ogoldeliy/fachwerk-project-173/Ведомости/04 ижд Ведомость.docx

# Список деталей

№стр. | Пор. № | Идент. № | Наименование | Кол. | Ш [мм] | В [мм] | Д [мм]
1 | 1 | Ель | Стойка | 3 | 100 | 200 | 590
2 | 2 | Ель | Поперечный подкос стены | 7 | 60 | 280 | 1436,863
3 | 1013 | Ель | Штихбалка | 1 | 100 | 200 | 4000
4 | 2000 | Ель | Стропила | 5 | 60 | 200 | 7700
5 | 2001 | Ель | Стропила | 5 | 60 | 200 | 2554,227
6 | 2002 | Ель | Стропила | 19 | 60 | 200 | 6707,021
7 | 2003 | Ель | Стропила | 10 | 60 | 280 | 5385,251
8 | 2004 | Ель | Стропила | 5 | 60 | 200 | 1545,027
9 | 4000 | Ель | Мауэрлат | 1 | 200 | 200 | 4000
10 | 4001 | Ель | Мауэрлат | 1 | 200 | 200 | 4000
11 | 4002 | Ель | Мауэрлат | 1 | 160 | 200 | 1664
12 | 4003 | Ель | Мауэрлат | 1 | 160 | 200 | 7793,067
13 | 4004 | Ель | Мауэрлат | 1 | 200 | 200 | 6910
14 | 4005 | Ель | Мауэрлат | 1 | 200 | 200 | 6910
15 | 4006 | Ель | Мауэрлат | 1 | 200 | 200 | 9060
16 | 4007 | Ель | Мауэрлат | 1 | 200 | 200 | 3720
17 | 4008 | Ель | Мауэрлат | 1 | 200 | 200 | 3720
18 | 4009 | Ель | Мауэрлат | 1 | 200 | 200 | 6895
19 | 4010 | Ель | Мауэрлат | 1 | 200 | 200 | 5685
20 | 4011 | Ель | Мауэрлат | 1 | 200 | 200 | 3495
21 | 4012 | Ель | Мауэрлат | 1 | 200 | 200 | 5685
22 | 4013 | Ель | Стропила | 1 | 200 | 200 | 7700
23 | 4014 | Ель | Стропила | 1 | 160 | 160 | 1698,766
24 | 4015 | Ель | Стропила | 1 | 200 | 200 | 6707,021
25 | 4016 | Ель | Стропила | 1 | 160 | 280 | 5385,251
26 | 4017 | Ель | Стропила | 1 | 160 | 280 | 5385,251
27 | 4018 | Ель | Стропила | 1 | 160 | 280 | 5385,251
28 | 4019 | Ель | Стропила | 1 | 160 | 280 | 5385,251
29 | 4020 | Ель | Стропила | 1 | 200 | 200 | 6707,021
30 | 4021 | Ель | Стропила | 1 | 200 | 200 | 6707,021
31 | 4022 | Ель | Затяжка | 1 | 60 | 200 | 6240
32 | 4023 | Ель | Затяжка | 1 | 60 | 200 | 7430
33 | 4024 | Ель | Затяжка | 1 | 60 | 200 | 709,999
34 | 4025 | Ель | Затяжка | 1 | 60 | 200 | 6240
35 | 4026 | Ель | Затяжка | 1 | 60 | 200 | 11710
36 | 4027 | Ель | Вспомогательная балка | 1 | 100 | 200 | 1970
37 | 4028 | Ель | Вспомогательная балка | 1 | 100 | 280 | 8239,943
38 | 4029 | Ель | Балка | 1 | 100 | 280 | 8319,943
39 | 4030 | Ель | Балка | 1 | 100 | 280 | 9580
40 | 4031 | Ель | Вспомогательная балка | 1 | 100 | 200 | 4060
41 | 4032 | Ель | Вспомогательная балка | 1 | 100 | 200 | 4060
42 | 4033 | Ель | Балка | 1 | 100 | 280 | 9580
43 | 4034 | Ель | Вспомогательная балка | 1 | 100 | 200 | 3180
44 | 4035 | Ель | Балка | 1 | 100 | 280 | 8319,943
45 | 4036 | Ель | Вспомогательная балка | 1 | 100 | 200 | 1970
46 | 4037 | Ель | Нижн. обвязка | 1 | 200 | 200 | 1945
47 | 4038 | Ель | Нижн. обвязка | 1 | 160 | 200 | 6205
48 | 4039 | Ель | Нижн. обвязка | 1 | 160 | 200 | 6205
49 | 4040 | Ель | Нижн. обвязка | 1 | 200 | 280 | 2045
50 | 4041 | Ель | Нижн. обвязка | 1 | 160 | 200 | 11675,001
51 | 4042 | Ель | Нижн. обвязка | 1 | 200 | 280 | 11675,001
52 | 4043 | Ель | Нижн. обвязка | 1 | 200 | 280 | 4540
53 | 4044 | Ель | Нижн. обвязка | 1 | 200 | 280 | 8520
54 | 4045 | Ель | Нижн. обвязка | 1 | 200 | 280 | 7395
55 | 4046 | Ель | Нижн. обвязка | 1 | 200 | 200 | 10365
56 | 4047 | Ель | Нижн. обвязка | 1 | 160 | 200 | 4540
57 | 4048 | Ель | Нижн. обвязка | 1 | 160 | 200 | 1945
58 | 4049 | Ель | Нижн. обвязка | 1 | 160 | 200 | 11710
59 | 4050 | Ель | Нижн. обвязка | 1 | 160 | 199,999 | 6205
60 | 4051 | Ель | Нижн. обвязка | 1 | 160 | 199,999 | 6205
61 | 4052 | Ель | Нижн. обвязка | 1 | 160 | 200 | 1945
62 | 4053 | Ель | Нижн. обвязка | 1 | 200 | 280 | 11735
63 | 4054 | Ель | Нижн. обвязка | 1 | 200 | 200 | 1945
64 | 4055 | Ель | Верхн. обвязка | 1 | 200 | 200 | 1050
65 | 4056 | Ель | Верхн. обвязка | 1 | 200 | 280 | 1200
66 | 4057 | Ель | Верхн. обвязка | 1 | 200 | 280 | 1200,057
67 | 4058 | Ель | Верхн. обвязка | 1 | 200 | 200 | 1040
68 | 4059 | Ель | Верхн. обвязка | 1 | 200 | 280 | 9480
69 | 4060 | Ель | Верхн. обвязка | 1 | 200 | 200 | 8160
70 | 4061 | Ель | Верхн. обвязка | 1 | 200 | 280 | 8120
71 | 4062 | Ель | Нижн. обвязка | 1 | 200 | 200 | 4680
72 | 4063 | Ель | Столб | 1 | 200 | 200 | 2379,519
73 | 4064 | Ель | Столб | 1 | 200 | 200 | 2170
74 | 4065 | Ель | Столб | 1 | 200 | 200 | 2379,519
75 | 4066 | Ель | Столб | 1 | 200 | 200 | 3252,115
76 | 4067 | Ель | Столб | 1 | 200 | 200 | 3040
77 | 4068 | Ель | Столб | 1 | 200 | 200 | 3040
78 | 4069 | Ель | Столб | 1 | 160 | 200 | 1690
79 | 4070 | Ель | Столб | 1 | 60 | 200 | 780
80 | 4071 | Ель | Столб | 1 | 200 | 200 | 3040
81 | 4072 | Ель | Столб | 1 | 160 | 200 | 1690
82 | 4073 | Ель | Столб | 1 | 160 | 200 | 1690
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
160 x 280 | 4 | 21,540 | 19,316 | 0,964
200 x 200 | 57 | 213,132 | 175,068 | 8,523
200 x 280 | 10 | 65,910 | 64,393 | 3,691

www.dietrichs.com 4/4 Создано в Dietrich´s

www.dietrichs.com 1/4 Создано в Dietrich´s

Проект: _Оси 29.05.2019 Обьект: Координатна сетка
