ogoldeliy/fachwerk-project-173/Ведомости/04 ижд Доска.docx

# Список деталей

№стр. | Пор. № | Идент. № | Наименование | Кол. | Ш [мм] | В [мм] | Д [мм]
1 | 1000 | Сосна | Затяжка | 7 | 45 | 190 | 838,074
2 | 1001 | Сосна | Штихбалка | 1 | 45 | 190 | 1920
3 | 1002 | Сосна | Штихбалка | 6 | 45 | 190 | 1569,998
4 | 1003 | Сосна | Штихбалка | 3 | 45 | 190 | 1570,003
5 | 1004 | Сосна | Штихбалка | 21 | 45 | 145 | 1990
6 | 1005 | Сосна | Штихбалка | 7 | 45 | 145 | 1990,001
7 | 1006 | Сосна | Штихбалка | 3 | 45 | 190 | 1900,001
8 | 1007 | Сосна | Штихбалка | 14 | 45 | 145 | 1570,001
9 | 1008 | Сосна | Штихбалка | 7 | 45 | 145 | 1570
10 | 1009 | Сосна | Штихбалка | 6 | 45 | 190 | 1920
11 | 1010 | Сосна | Штихбалка | 21 | 45 | 145 | 1570,001
12 | 1011 | Сосна | Штихбалка | 3 | 45 | 190 | 1900,001
13 | 1012 | Сосна | Штихбалка | 1 | 45 | 190 | 1919,999
14 | 1014 | Сосна | Штихбалка | 9 | 45 | 190 | 1570,001
15 | 1015 | Сосна | Штихбалка | 6 | 45 | 190 | 1990
16 | 1016 | Сосна | Штихбалка | 1 | 45 | 190 | 4000
17 | 1017 | Сосна | Штихбалка | 2 | 45 | 190 | 4080
18 | 1018 | Сосна | Штихбалка | 8 | 45 | 190 | 4080
19 | 1019 | Сосна | Штихбалка | 8 | 45 | 190 | 4210
20 | 1020 | Сосна | Штихбалка | 2 | 45 | 190 | 4080
21 | 1021 | Сосна | Штихбалка | 1 | 45 | 190 | 4000
22 | 1022 | Сосна | Штихбалка | 8 | 45 | 190 | 2840

# Ведомость сечений

Каталожный№ | Кол. [Шт.] | Пог.м [м] | Повер. [м²] | Объём [м³]
Доска | 145 | 307,847 | 135,933 | 2,385
Итого | 145 | 307,847 | 135,933 | 2,385
45 x 145 | 70 | 121,660 | 47,145 | 0,794
45 x 190 | 69 | 174,247 | 83,074 | 1,489
45 x 190 | 6 | 11,940 | 5,714 | 0,102

www.dietrichs.com 2/2 Создано в Dietrich´s

www.dietrichs.com 1/1 Создано в Dietrich´s

Проект: _Оси 29.05.2019 Обьект: Координатна сетка
