ogoldeliy/fachwerk-project-173/(list of files, cad)

Other CAD files:
02 ижд АР.dwg
