ogoldeliy/fachwerk-project-173/02 ижд АР.pdf

Общий вид. Аксонометрия.

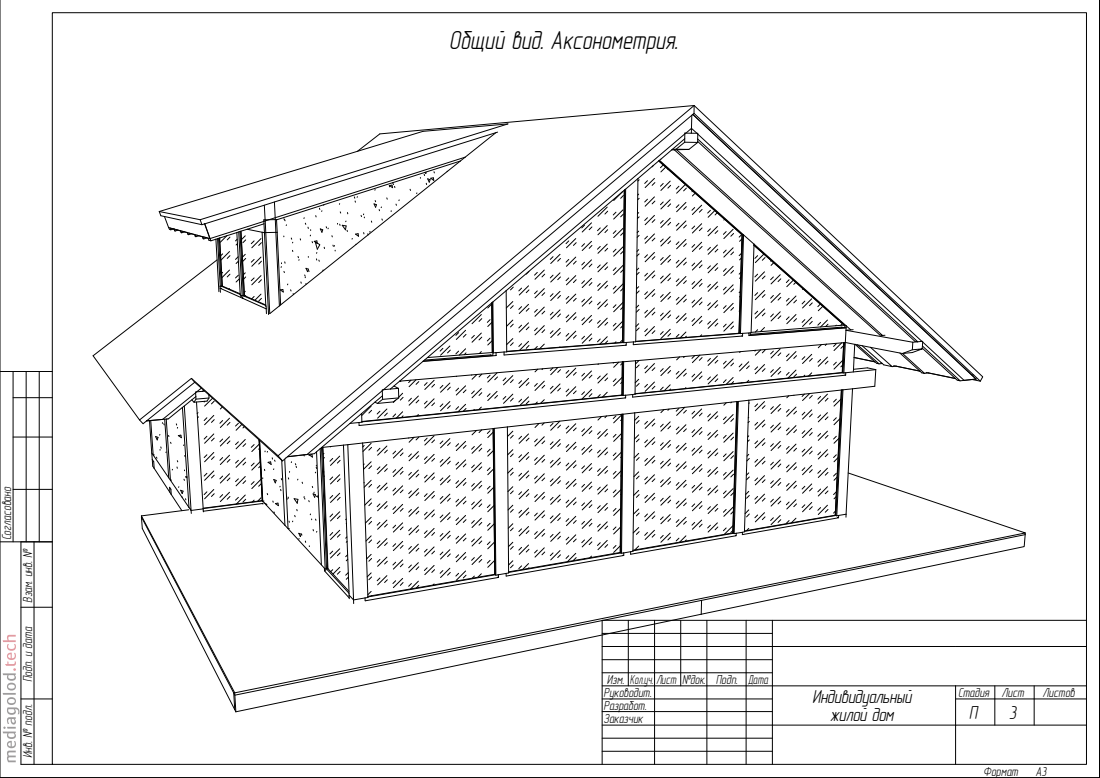
[picture p1: page 1]
Стадия; Лист; Листов; Индивидуальный; жилой дом; Соглас; ван; Формат A3

Инв. № подл. Подп. и дата Взам. инв. №

Изм. Кол.уч. Лист №док. Руководит. | Подп. | Дата
Разработ.
Заказчик

# Общий вид. Аксонометрия. Инв. № подл. Подп. и дата Взам. инв. №

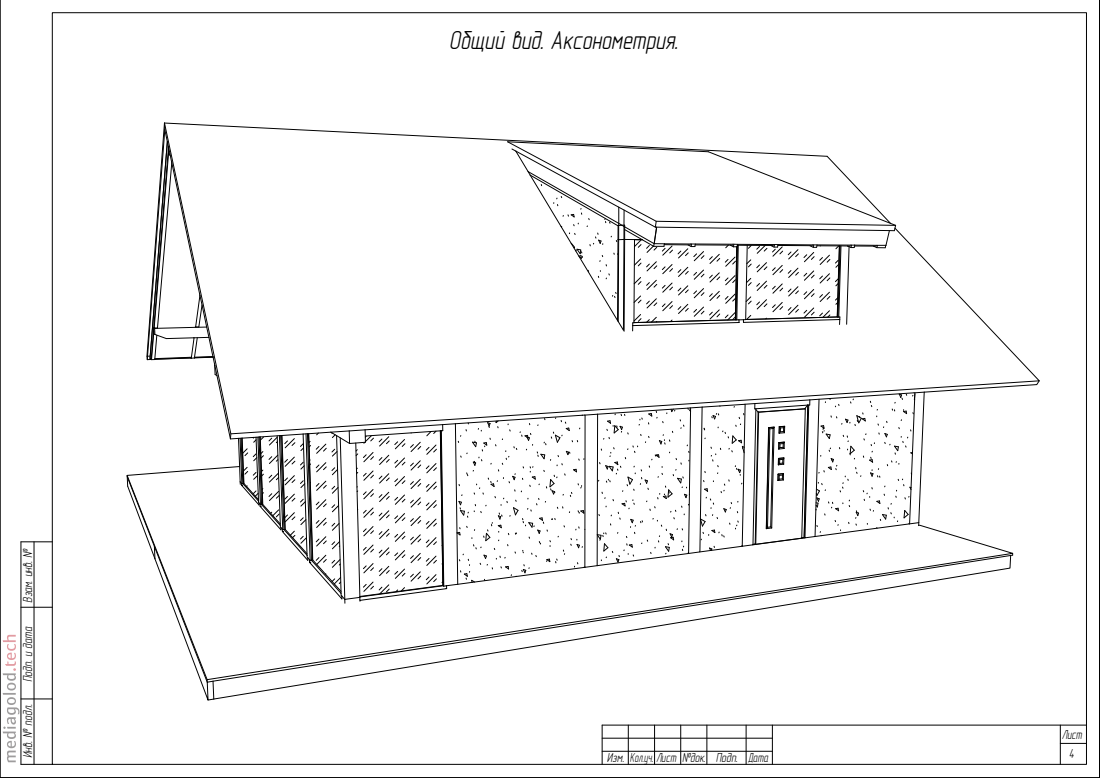
[picture p2: page 2]
Изм. Кол.уч. Лист №док.; Подп.; Дата; Лист

# Общий вид. Аксонометрия. Инв. № подл. Подп. и дата Взам. инв. №

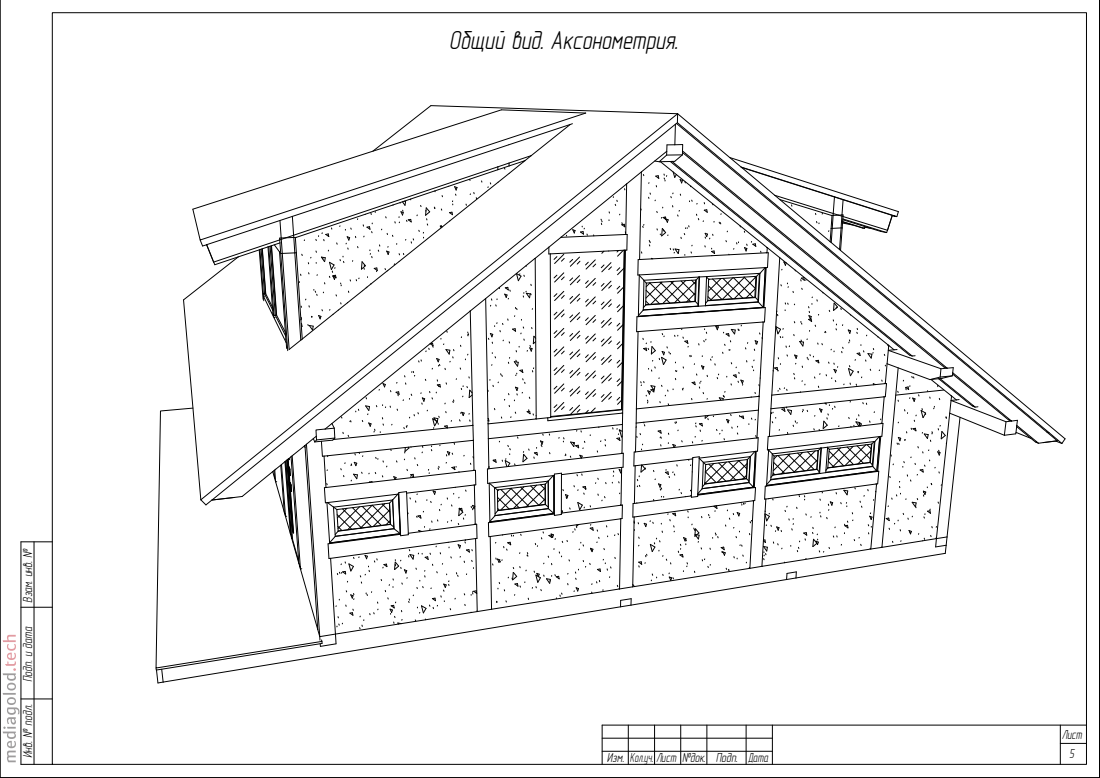
[picture p3: page 3]

# Общий вид. Аксонометрия. Инв. № подл. Подп. и дата Взам. инв. №

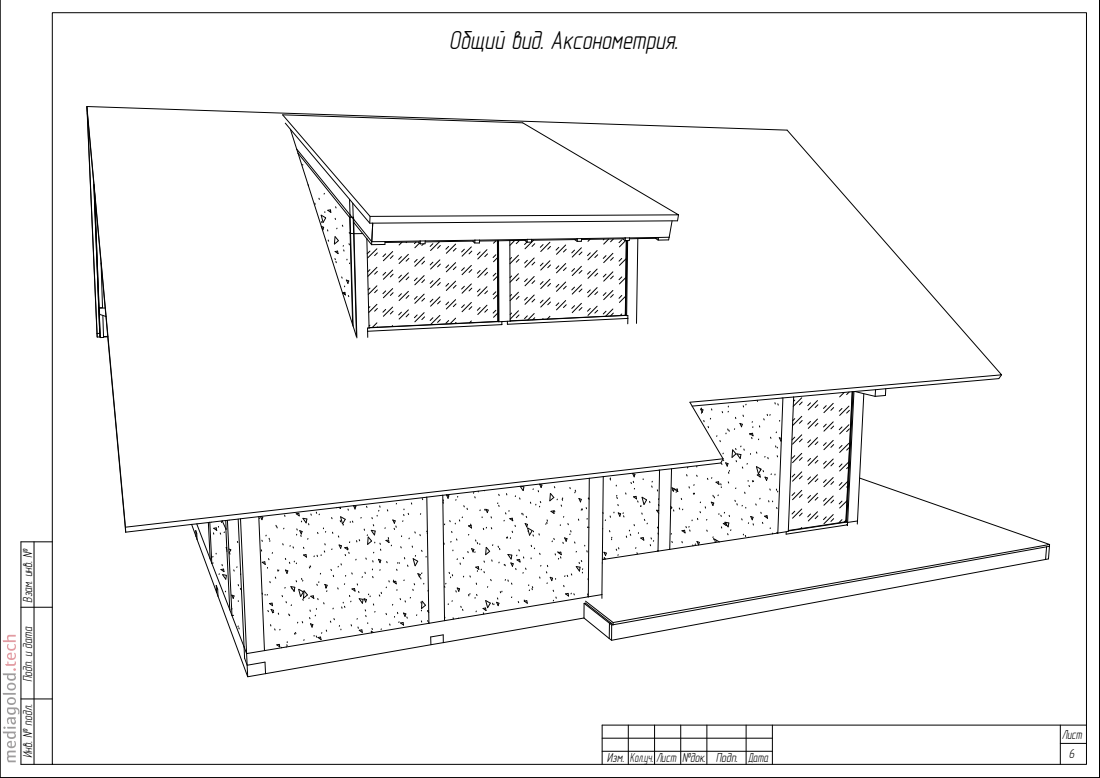
[picture p4: page 4]

# План

# первого

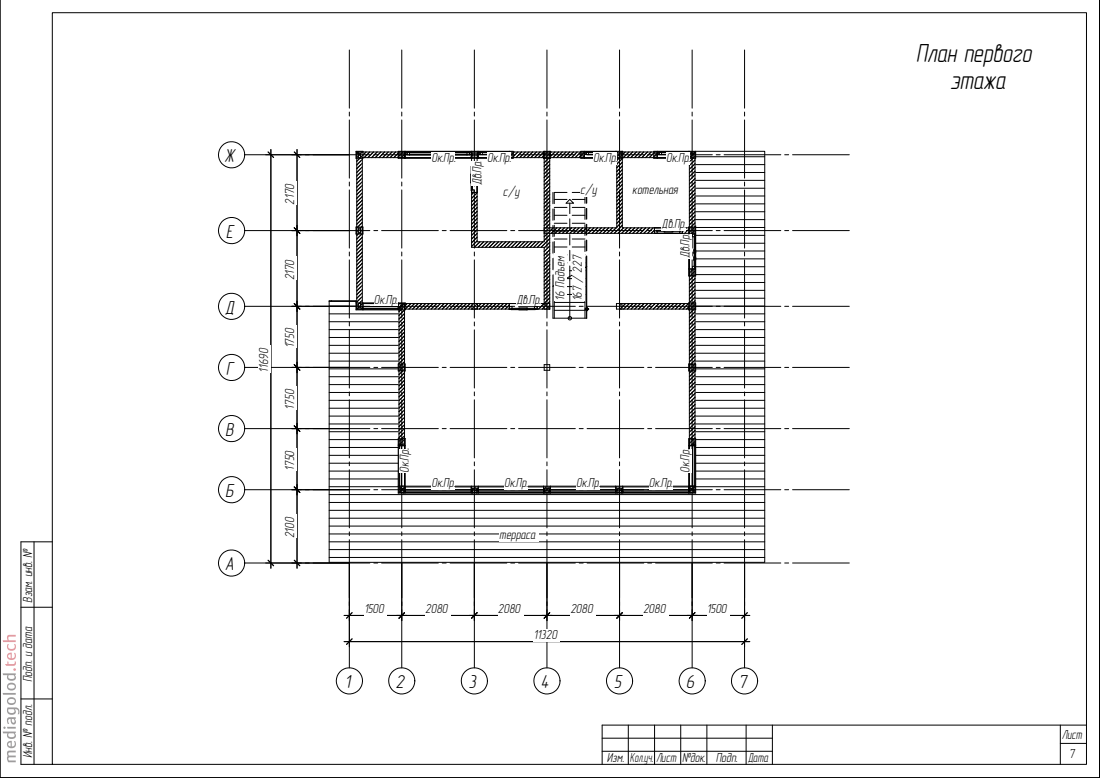
[picture p5: page 5]
ажа; План; первого эт; ерраса; тель; ная; 167 / ²²⁷ Подъем терраса; 167 / ²²⁷ Подъем; №док.; Подп.; Дата; Лист7

Инв. № подл. Подп. и дата Взам. инв. №

Изм. Кол.уч. Лист

# План

вт

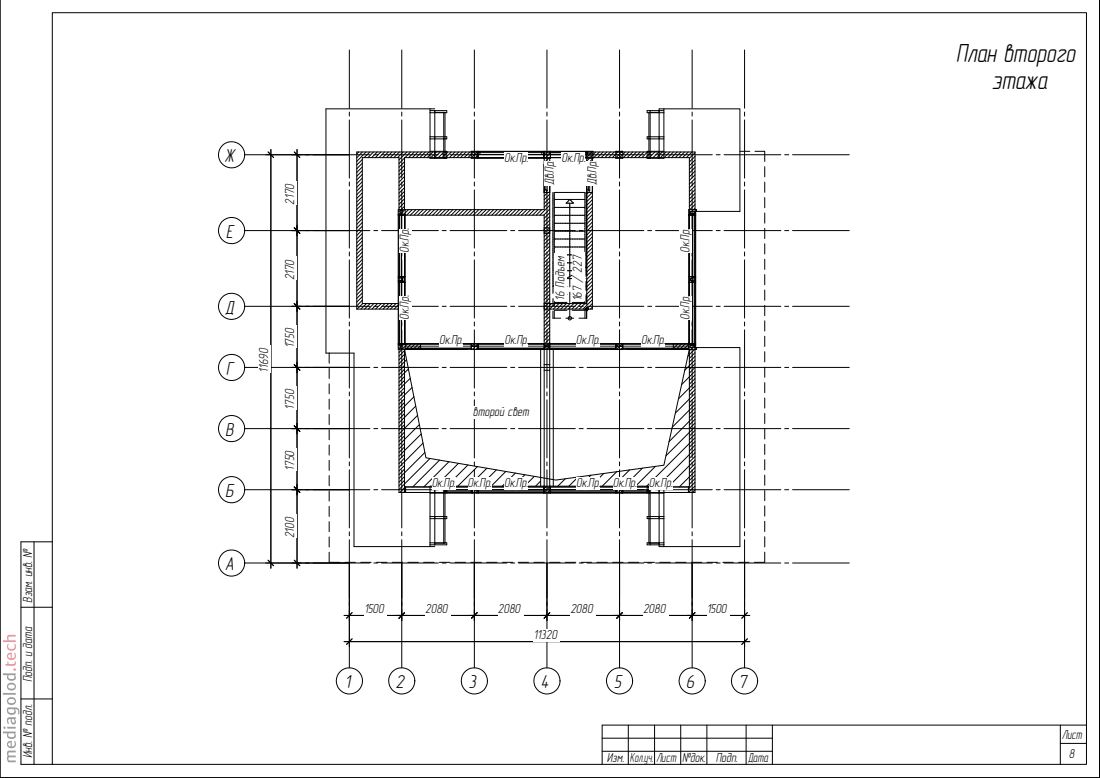
[picture p6: page 6]
орого; ажа; План; орой; свет; 167 / ²²⁷ Подъем; №док.; Подп.; Дата; Лист8

Инв. № подл. Подп. и дата Взам. инв. №

Изм. Кол.уч. Лист

# План

# кровли

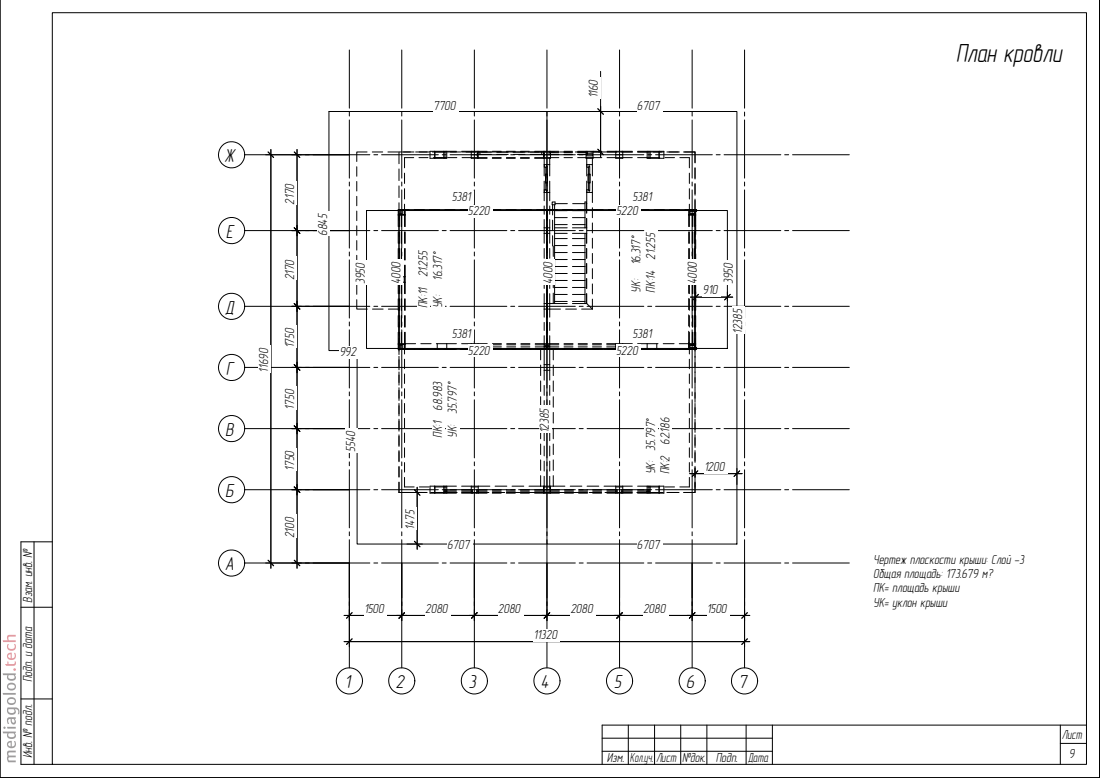
[picture p7: page 7]
лоскости крыши:; Слой -; адь: 173.679; Чертеж; Общая; площ; №док.; Подп.; Дата; Лист9

Инв. № подл. Подп. и дата Взам. инв. №

Чертеж
Общая
ПК= площадь крыши
УК= уклон крыши

площ

Изм. Кол.уч. Лист

# Фасад в осях Е-А

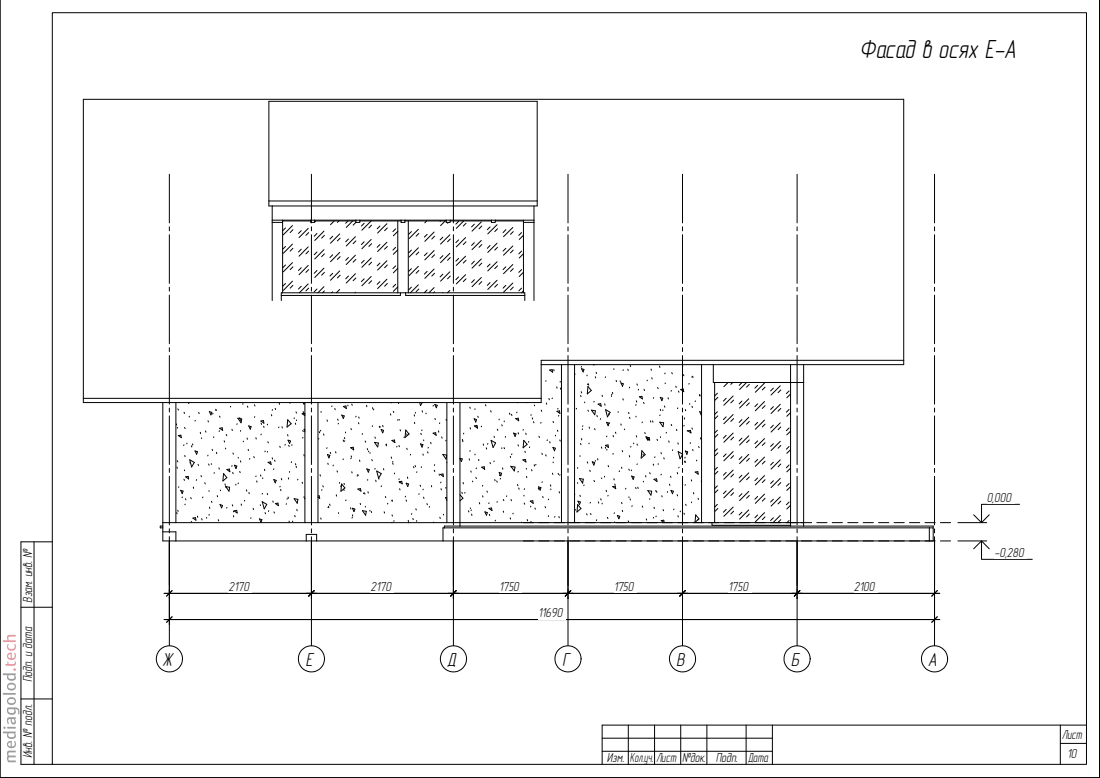
[picture p8: page 8]

Инв. № подл. Подп. и дата Взам. инв. №

# Фасад в осях 1-4

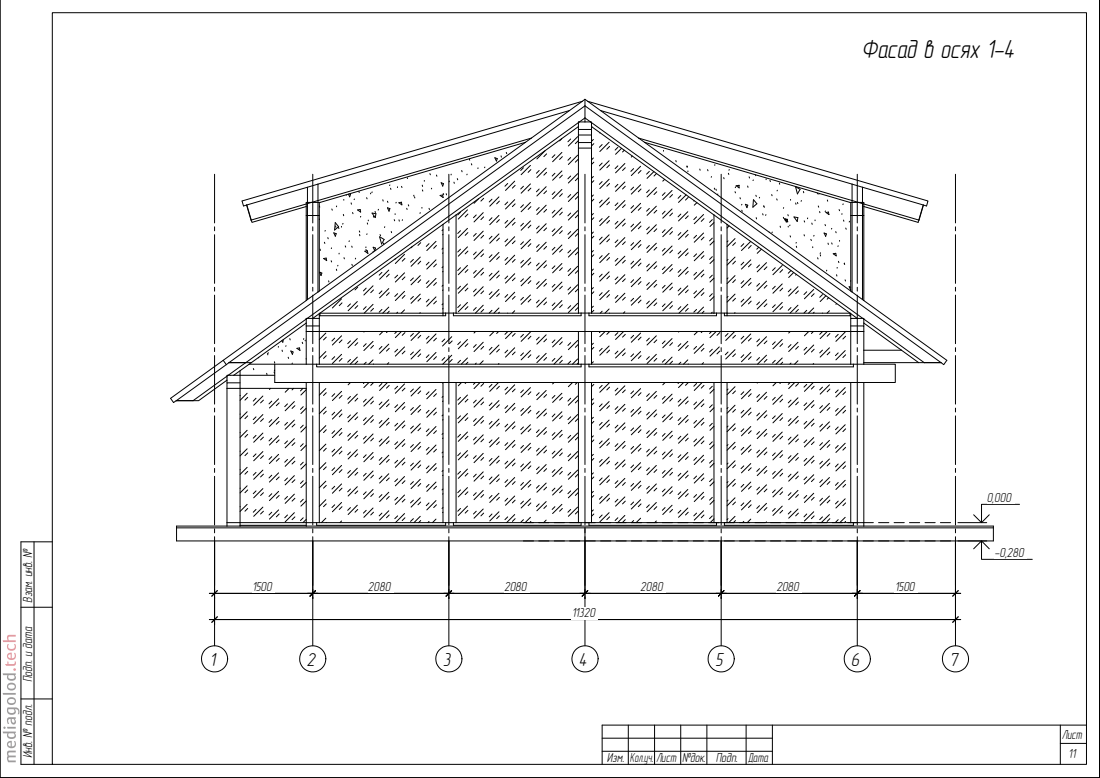
[picture p9: page 9]

Инв. № подл. Подп. и дата Взам. инв. №

# Фасад в осях 4-1

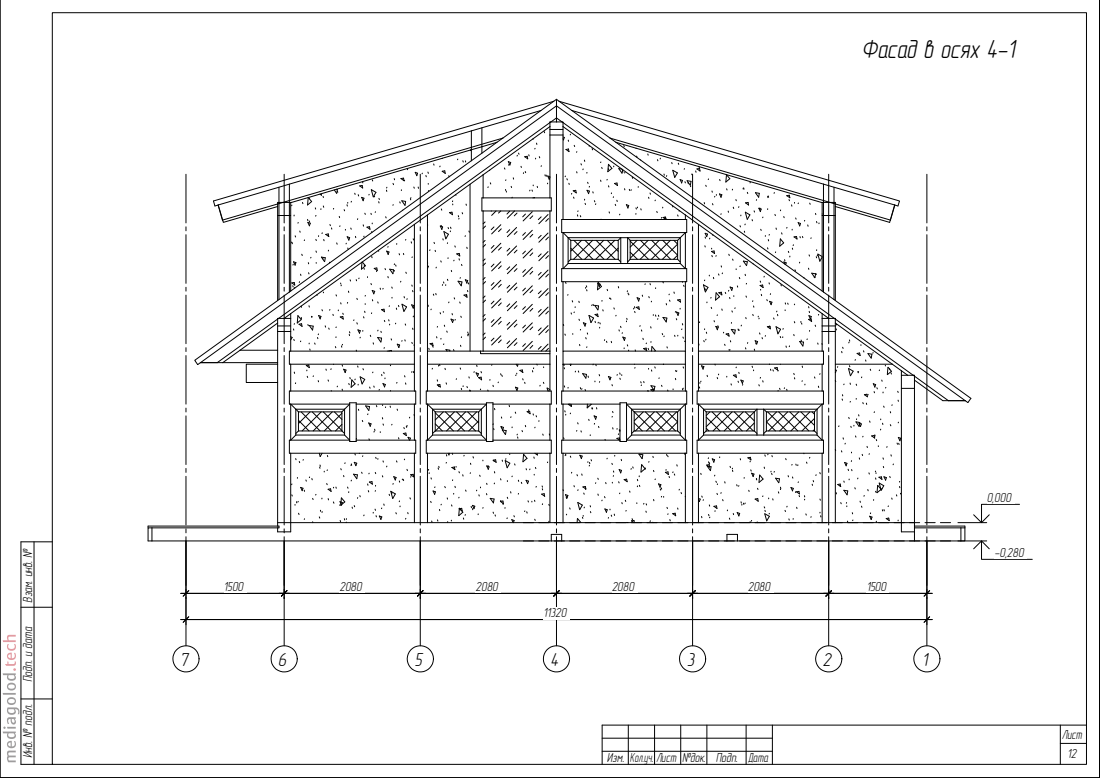
[picture p10: page 10]

Инв. № подл. Подп. и дата Взам. инв. №

# Фасад в осях А-Е

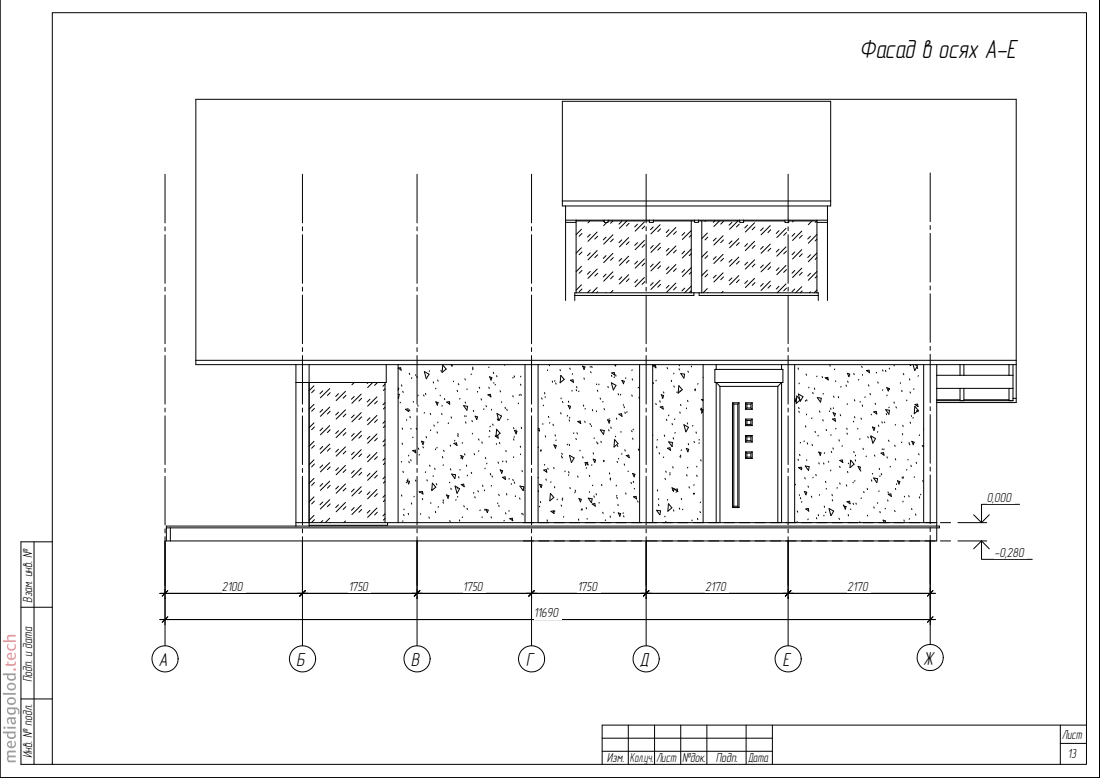
[picture p11: page 11]

Инв. № подл. Подп. и дата Взам. инв. №

# Разрез 1-1

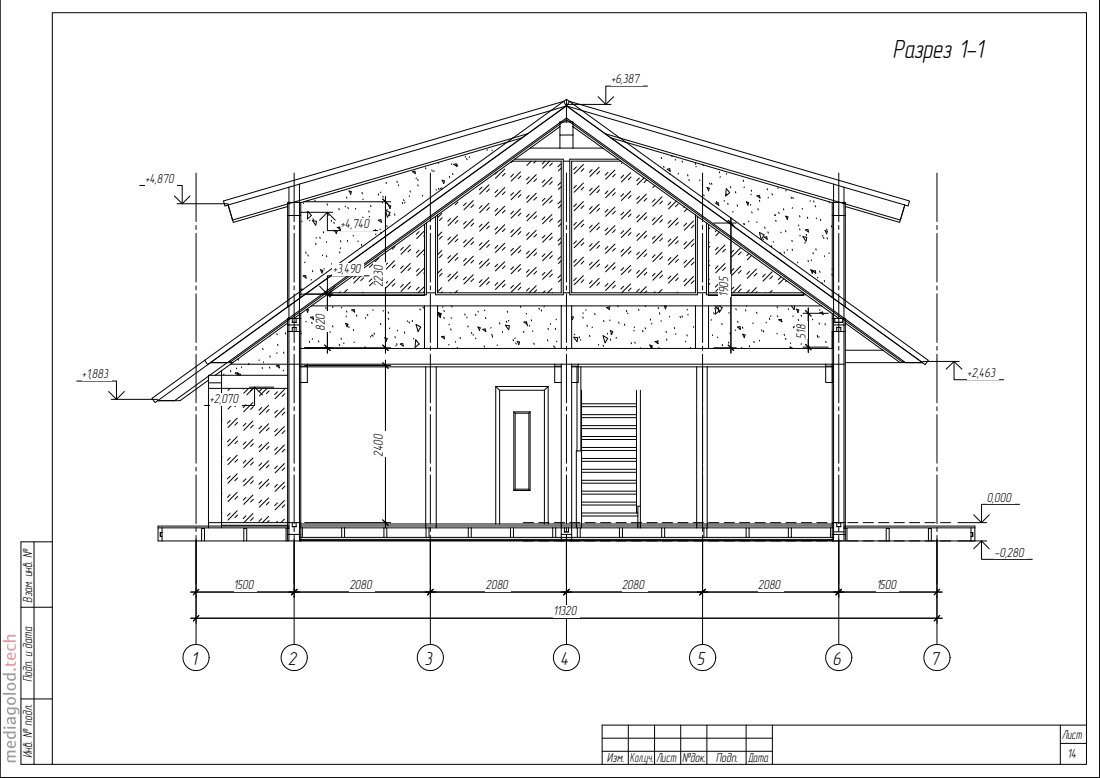
[picture p12: page 12]

Инв. № подл. Подп. и дата Взам. инв. №
