ogoldeliy/fachwerk-project-173/02 ижд Планы.pdf

# План

# первого

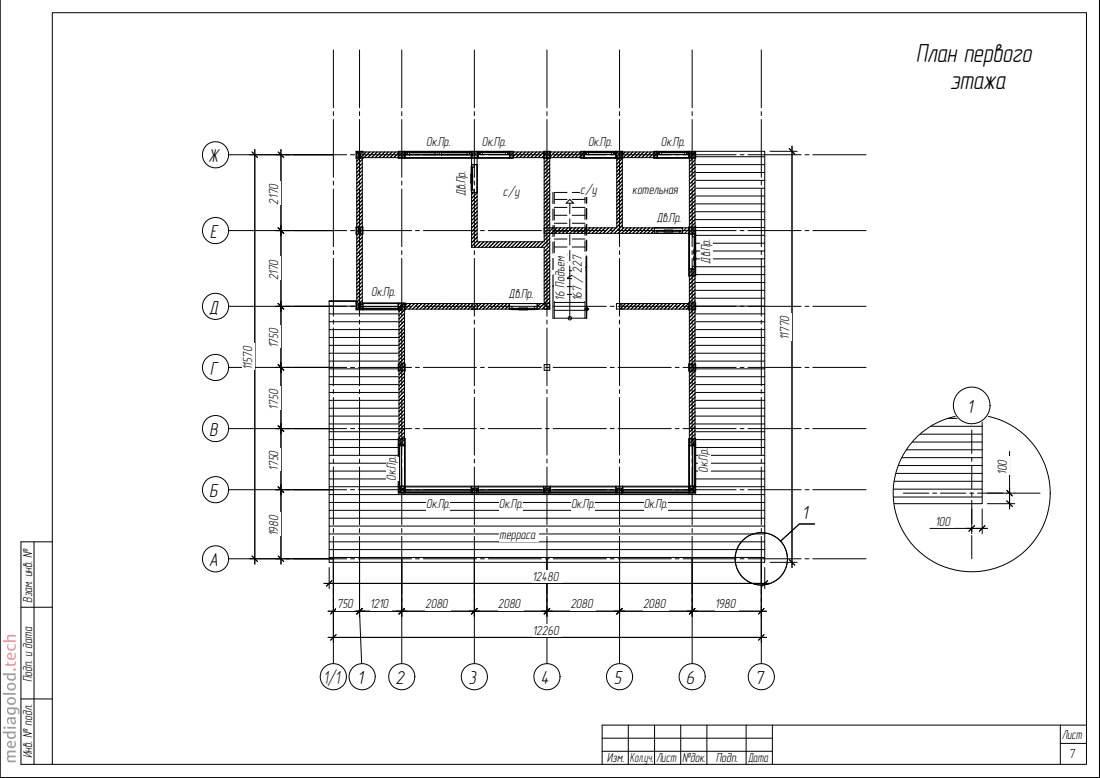
[picture p13: page 1]
ажа; План; первого эт; ерраса с/у; тель; ная; 167 / ²²⁷ Подъем терраса с/у; котельная; 167 / ²²⁷ Подъем; №док.; Подп.; Дата; Лист7

Инв. № подл. Подп. и дата Взам. инв. №

Изм. Кол.уч. Лист
