ogoldeliy/fachwerk-project-173/03 ижд КД.pdf

# План раскладки балок нижней обвязки

Ж

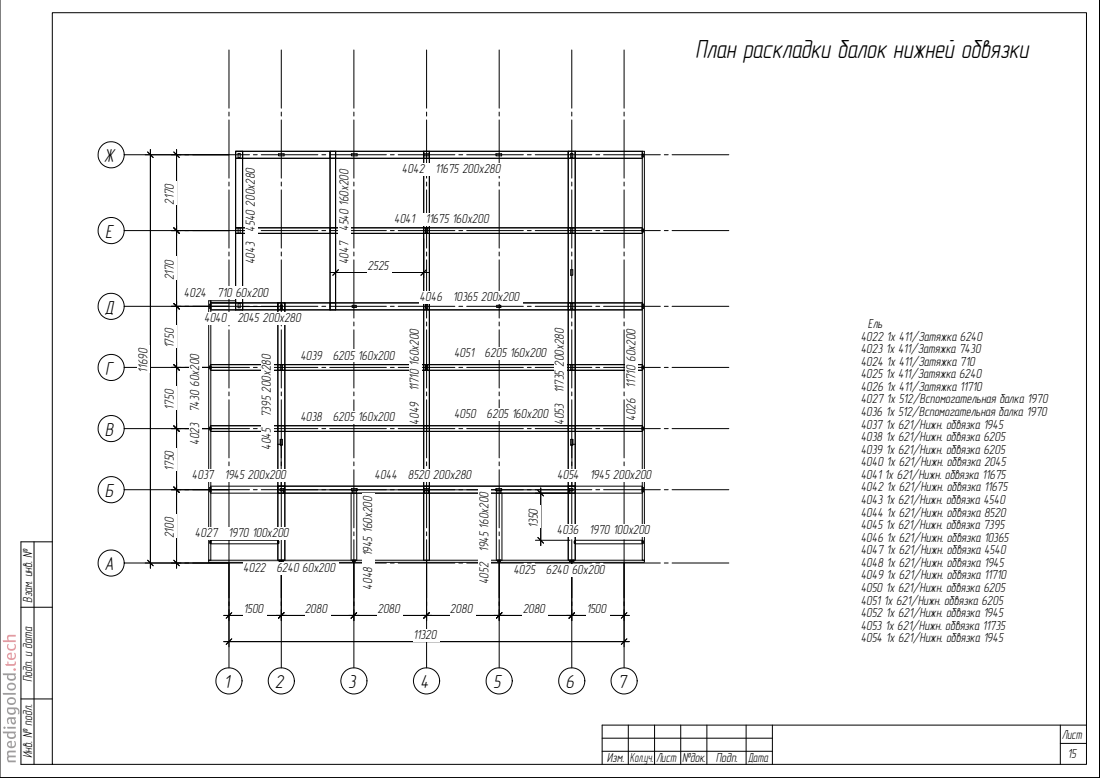
[picture p14: page 1]
Ель 4022 1x 411/Затяжка 6240 4023 1x 411/Затяжка 7430 4024 1x 411/Затяжка 710 4025 1x 411/Затяжка 6240 4026 1x 411/Затяжка 11710 4027 1x 512/Вспомогательная балка 1970 4036 1x 512/Вспомогательная балка 1970 4037 1x 621/Нижн. обвязка 1945 4038 1x 621/Нижн. обвязка 6205 4039 1x 621/Нижн. обвязка 6205 4040 1x 621/Нижн. обвязка 2045 4041 1x 621/Нижн. обвязка 11675 4042 1x 621/Нижн. обвязка 11675 4043 1x 621/Нижн. обвязка 4540 4044 1x 621/Нижн. обвязка 8520 4045 1x 621/Нижн. обвязка 7395 4046 1x 62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

Инв. № подл. Подп. и дата Взам. инв. №

# План раскладки лагтпола первого этажа и террас

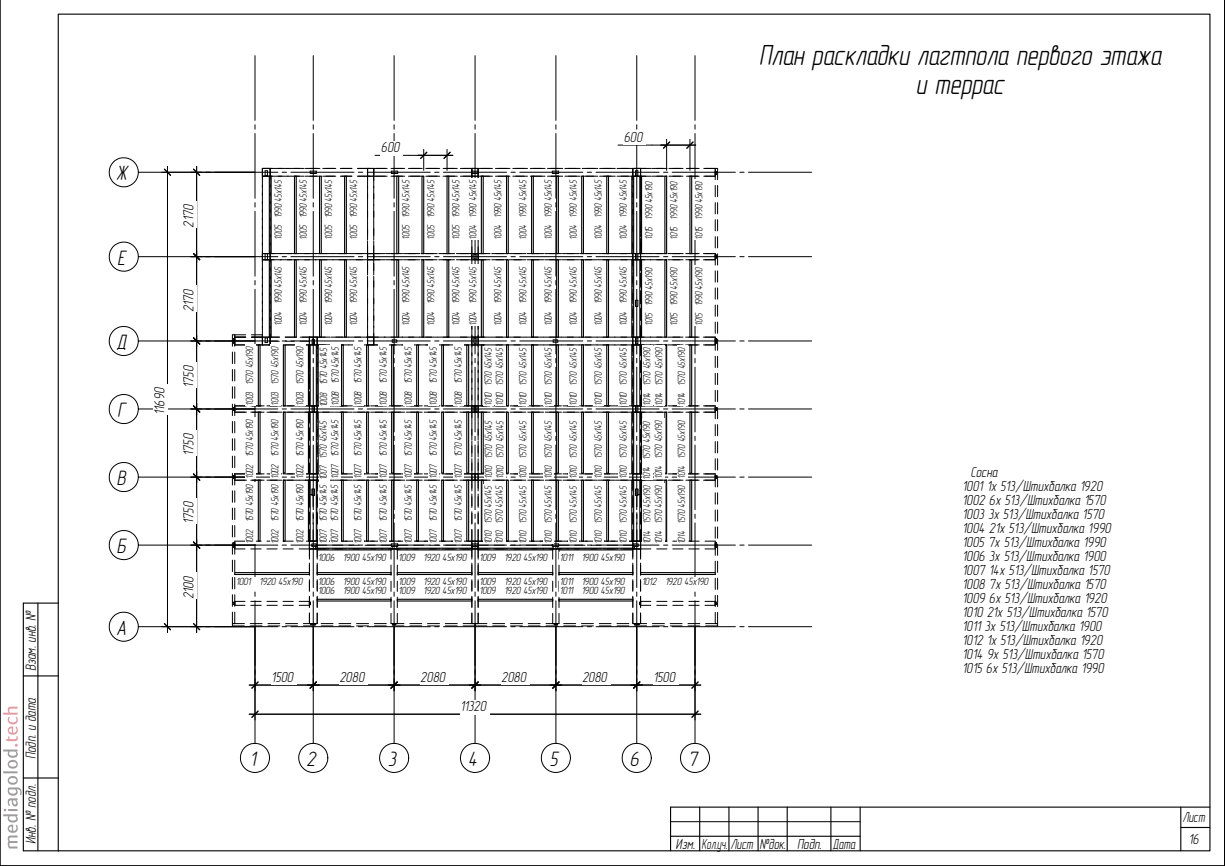
[picture p15: page 2]
и террас; Сосна 1001 1x 513/Штихбалка 1920 1002 6x 513/Штихбалка 1570 1003 3x 513/Штихбалка 1570 1004 21x 513/Штихбалка 1990 1005 7x 513/Штихбалка 1990 1006 3x 513/Штихбалка 1900 1007 14x 513/Штихбалка 1570 1008 7x 513/Штихбалка 1570 1009 6x 513/Штихбалка 1920 1010 21x 513/Штихбалка 1570 1011 3x 513/Штихбалка 1900 1012 1x 513/Штихбалка 1920 1014 9x 513/Штихбалка 1570 1015 6x 513/Штихбалка 1990; 1012 1920 45x190 ¹⁰⁰⁷ ¹⁵⁷⁰ ⁴⁵x¹45 ¹008 ¹570 45x¹45; 1011 1900 45x190 ¹⁰⁰⁷ ¹⁵⁷⁰ ⁴⁵x¹45

План раскладки лагтпола первого этажа

Инв. № подл. Подп. и дата Взам. инв. №

# План

# уст

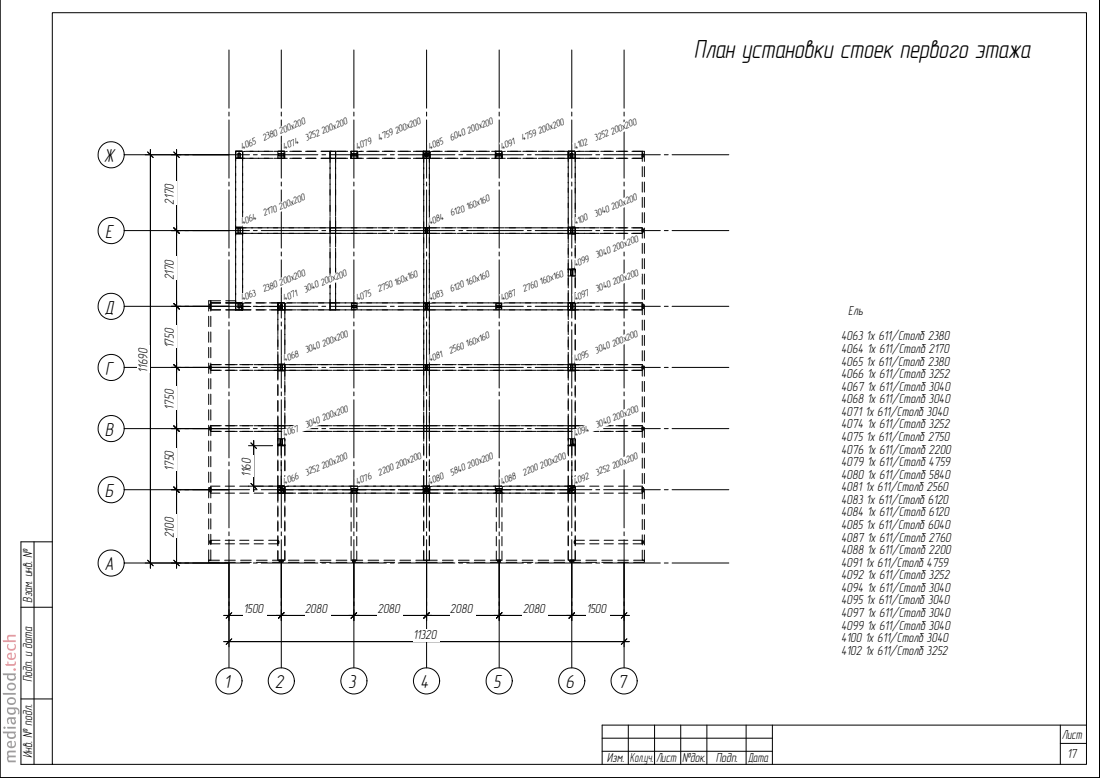
[picture p16: page 3]
ановки; оек; первого; ажа; Ель; олб; 611/Столб; олб 3040; олб 2750; олб 6040; олб 4759; олб 3252; №док.; Подп.; Дата

Инв. № подл. Подп. и дата Взам. инв. №

Изм. Кол.уч. Лист

# План

# раскладки

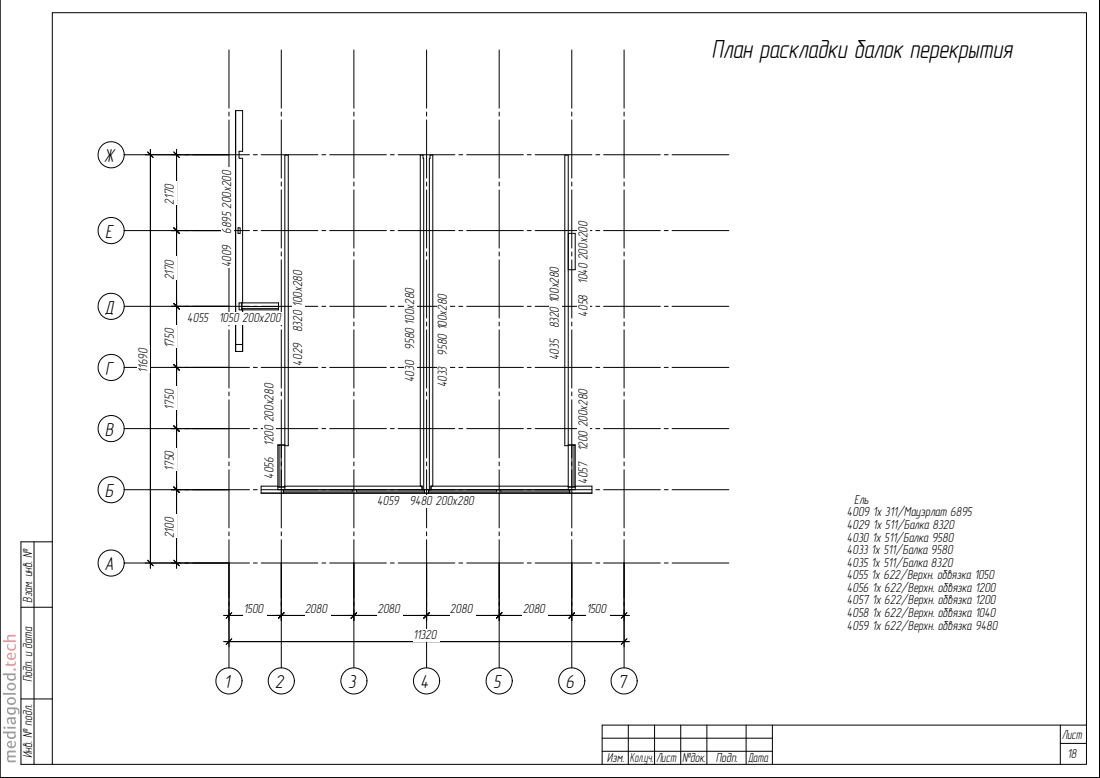
[picture p17: page 4]
балок; перекры; тия; 311/Мауэр; лат; 511/Балка; Ель; 4030 1x 511/Балка; №док.; Подп.; Дата

Ель
4030 1x 511/Балка
4055 1x 622/Верхн. обвязка 1050 4056 1x 622/Верхн. обвязка 1200 4057 1x 622/Верхн. обвязка 1200 4058 1x 622/Верхн. обвязка 1040 4059 1x 622/Верхн. обвязка 9480

Инв. № подл. Подп. и дата Взам. инв. №

Изм. Кол.уч. Лист

# План

# раскладки

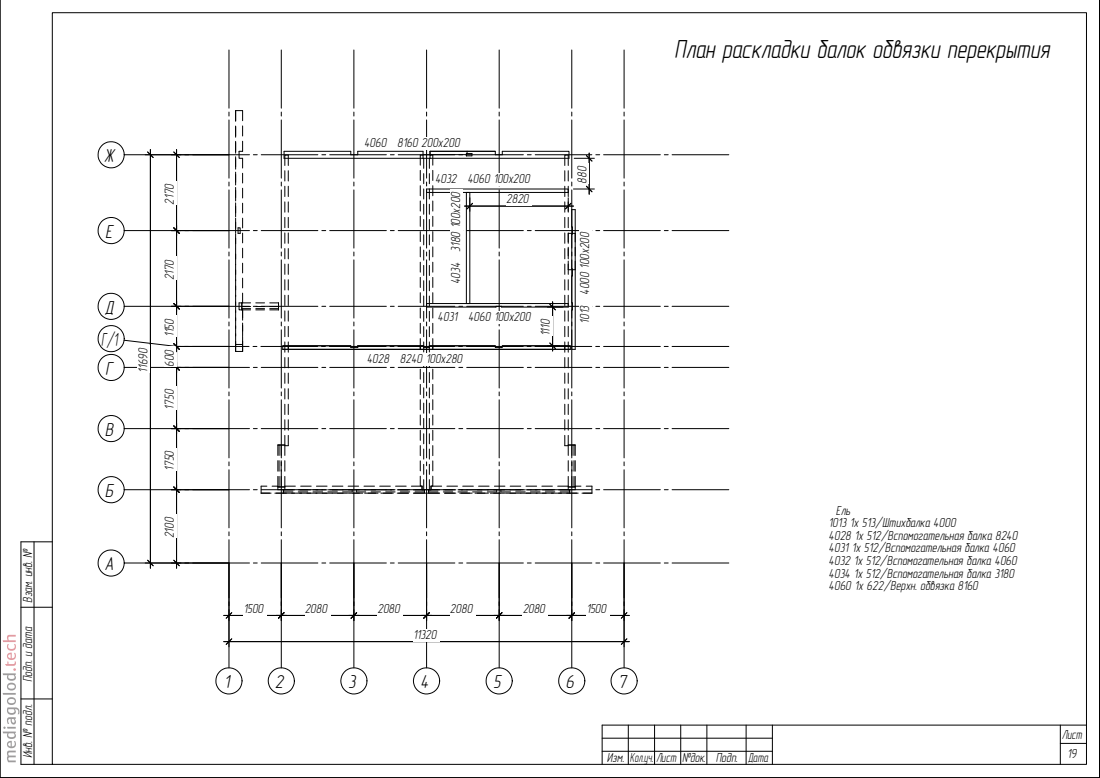
[picture p18: page 5]
балок; обвязки; перекры; тия; Ель 1013 1x 513/Штихбалка; 512/Всп; огател; ьная; балка; ьная балка; 4032 1x 512/Вспо; могат; ельная; балка 4060; 4034 1x 512/Вспо; 4060 1x 622/Верхн. обвязка; №док.; Подп.; Дата

Инв. № подл. Подп. и дата Взам. инв. №

Изм. Кол.уч. Лист

# План раскладки лаг перекрытия

Ж

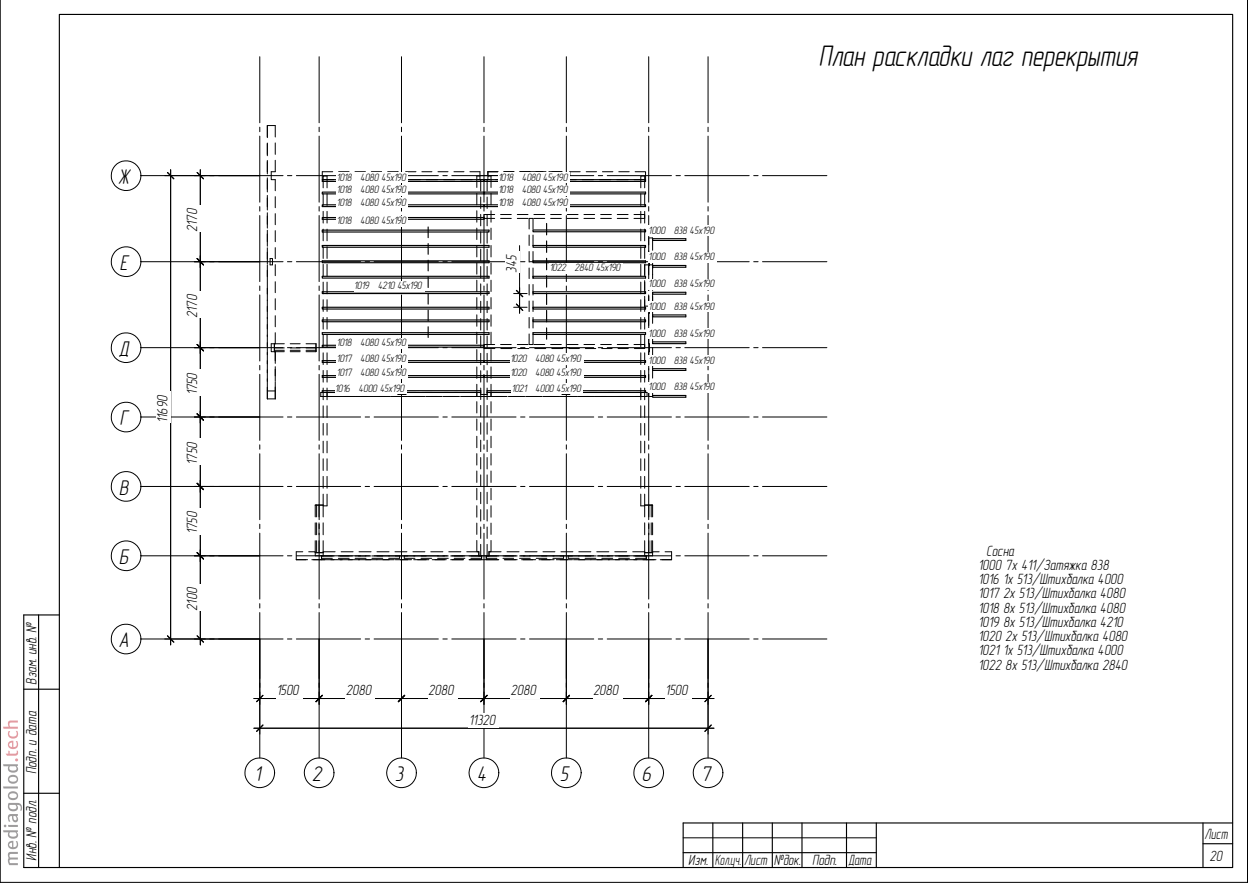
[picture p19: page 6]
Сосна 1000 7x 411/Затяжка 838 1016 1x 513/Штихбалка 4000 1017 2x 513/Штихбалка 4080 1018 8x 513/Штихбалка 4080 1019 8x 513/Штихбалка 4210 1020 2x 513/Штихбалка 4080 1021 1x 513/Штихбалка 4000 1022 8x 513/Штихбалка 2840

1018 4080 45x190 | 1018 4080 45x190
1018 4080 45x190 | | 1018 4080 45x190

Инв. № подл. Подп. и дата Взам. инв. №

# План

ст

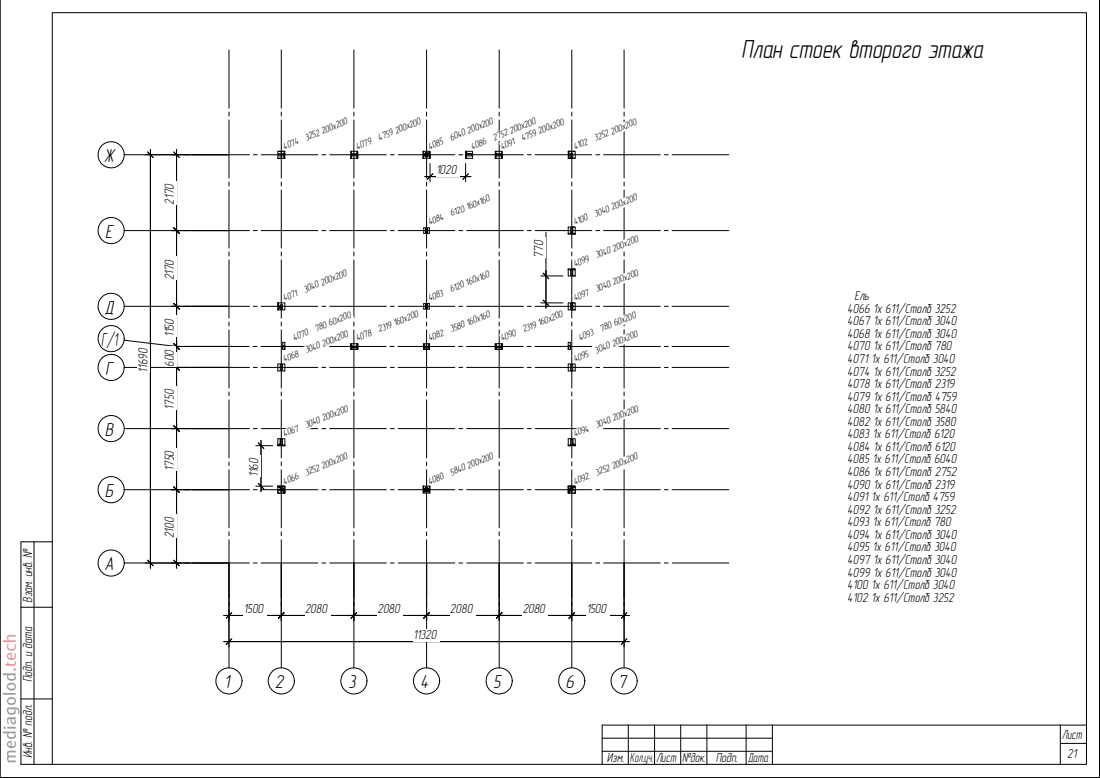
[picture p20: page 7]
оек; орого; ажа; Ель 4066 1x; 611/Столб; олб 3040; 611/Столб 3580; олб; олб 6040; олб 4759; олб 780; олб 3252; №док.; Подп.; Дата

Инв. № подл. Подп. и дата Взам. инв. №

Изм. Кол.уч. Лист

# План

# раскладки

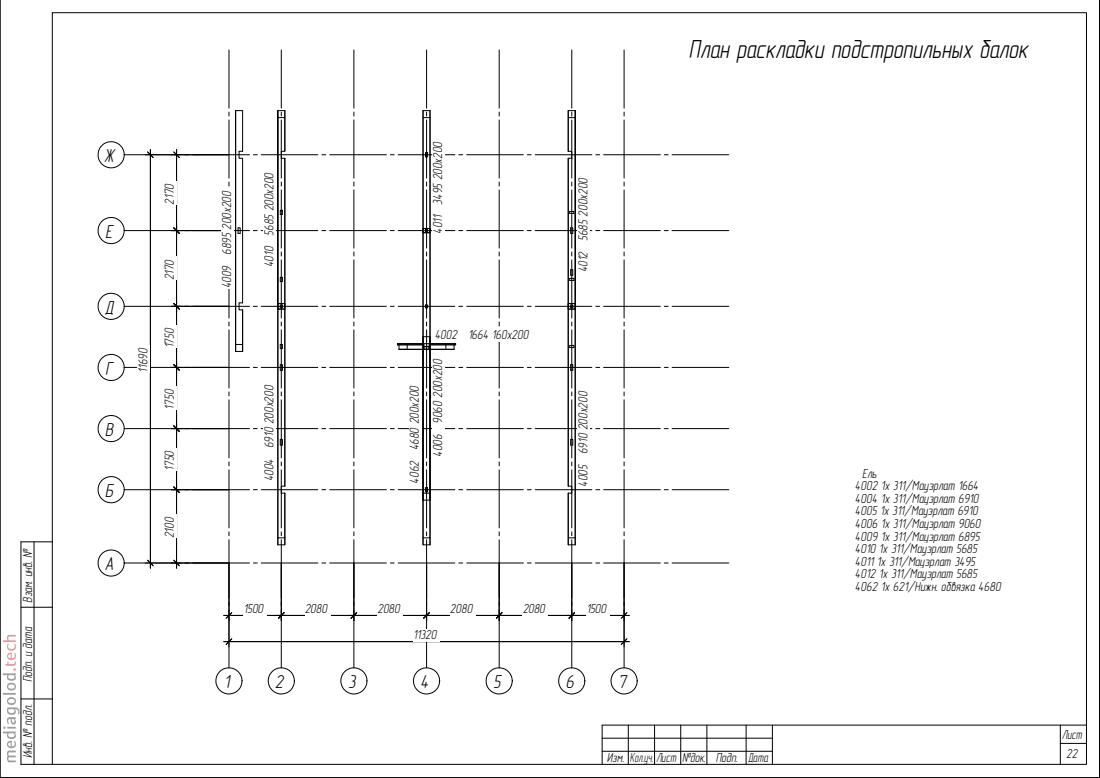
[picture p21: page 8]
подстропильных; балок; Ель 4002 1x 311/Мау; эрлат 1664 4004 1x 311/Мау; эрлат 6910; 311/Мауэр; лат; 4006 1x 311/Мау; эрлат 9060 4009 1x 311/Мау; эрлат 6895 4010 1x 311/Мауэр; лат 5685; 4011 1x 311/Мау; эрлат; 4012 1x 311/Мауэр; 621/Нижн. обвязка; №док.; Подп.; Дата

Инв. № подл. Подп. и дата Взам. инв. №

Изм. Кол.уч. Лист

# План раскладки стропил основной кровли

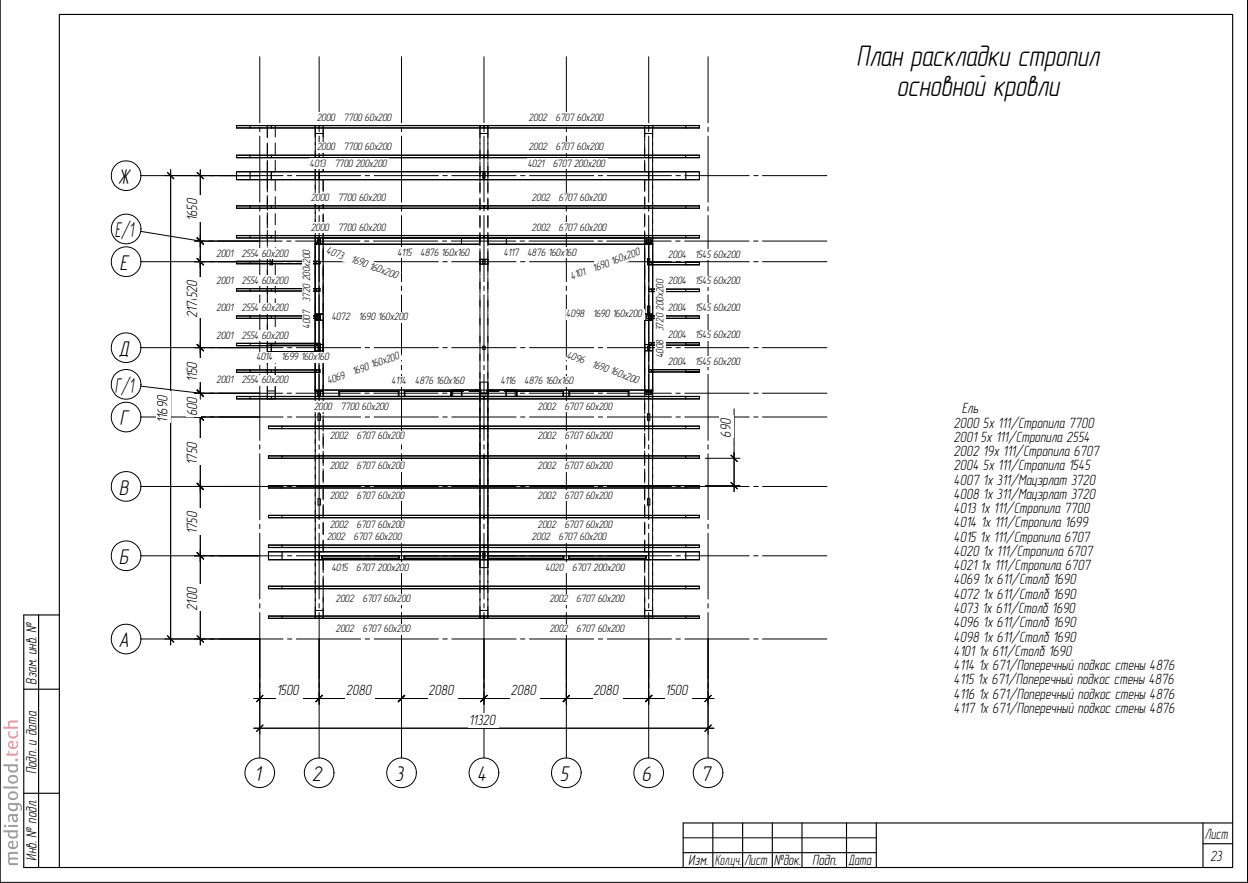
[picture p22: page 9]
Ель 2000 5x 111/Стропила 7700 2001 5x 111/Стропила 2554 2002 19x 111/Стропила 6707 2004 5x 111/Стропила 1545 4007 1x 311/Мауэрлат 3720 4008 1x 311/Мауэрлат 3720 4013 1x 111/Стропила 7700 4014 1x 111/Стропила 1699 4015 1x 111/Стропила 6707 4020 1x 111/Стропила 6707 4021 1x 111/Стропила 6707 4069 1x 611/Столб 1690 4072 1x 611/Столб 1690 4073 1x 611/Столб 1690 4096 1x 611/Столб 1690 4098 1x 611/Столб 1690 4101 1x 611/Столб 1690 4114 1x 671/Поперечный подкос стены 4876 4115 1x 671/Поперечный подко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

План раскладки стропил
основной кровли

Инв. № подл. Подп. и дата Взам. инв. №

4116 1x 671/Поперечный подкос стены 4876
4117 1x 671/Поперечный подкос стены 4876

# План раскладки стропил "кукушек"

Е/1

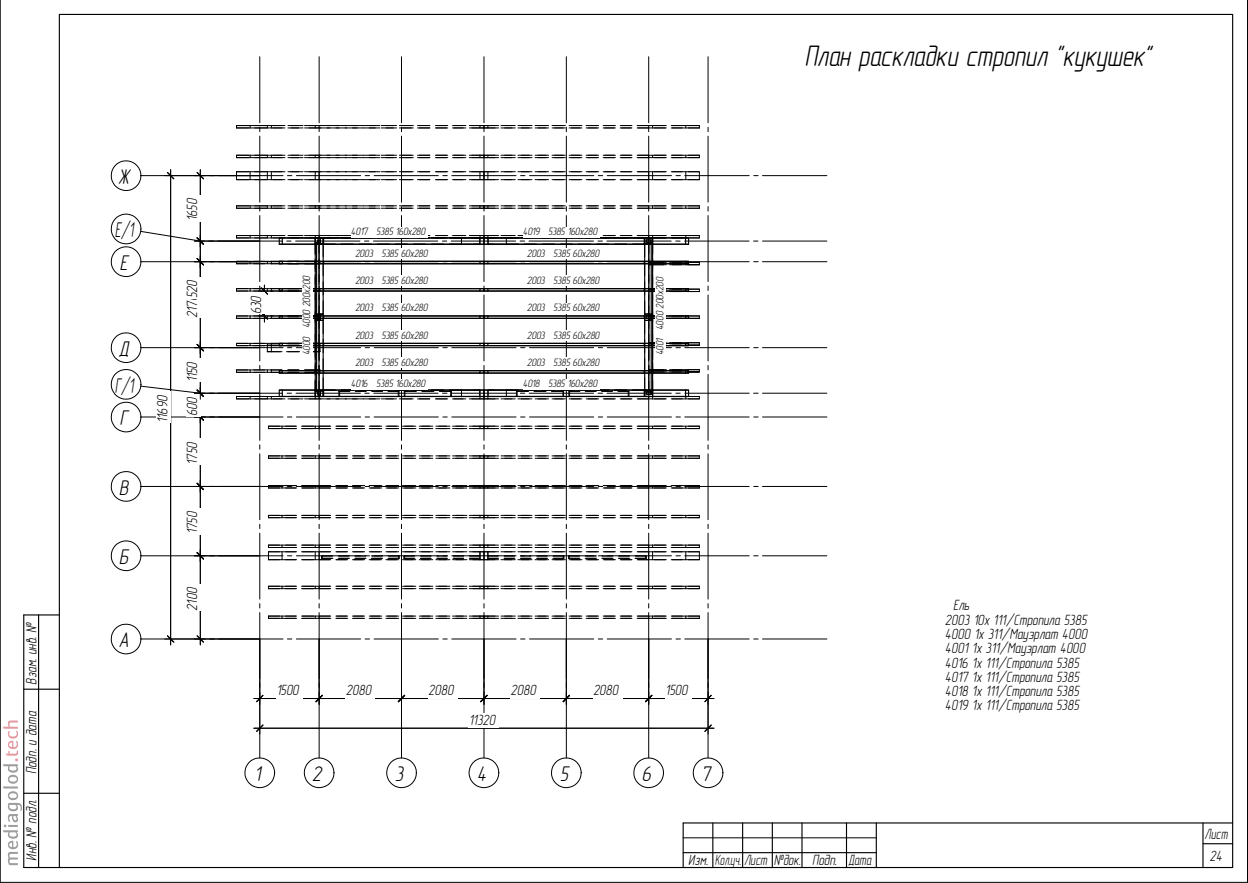
[picture p23: page 10]
Ель 2003 10x 111/Стропила 5385 4000 1x 311/Мауэрлат 4000 4001 1x 311/Мауэрлат 4000 4016 1x 111/Стропила 5385 4017 1x 111/Стропила 5385 4018 1x 111/Стропила 5385 4019 1x 111/Стропила 5385

Инв. № подл. Подп. и дата Взам. инв. №

# Развертка по оси Б

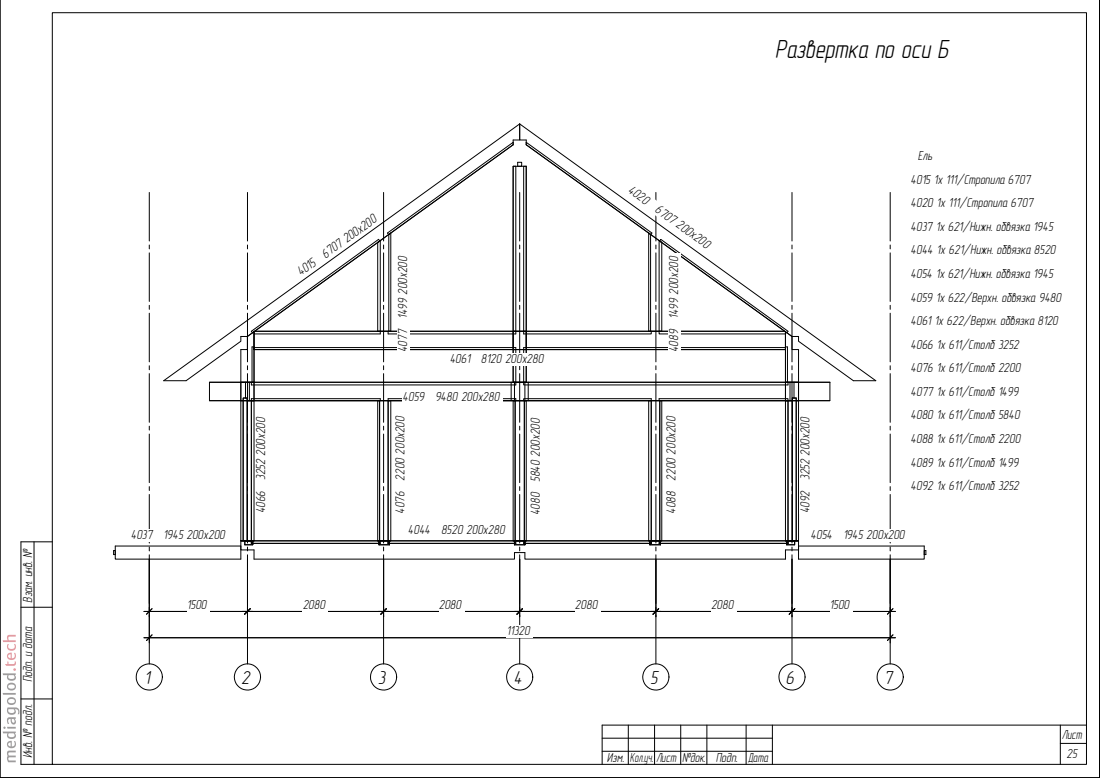
[picture p24: page 11]
Ель; 4015 1x 111/Стропила 6707; 4020 1x 111/Стропила 6707; 4037 1x 621/Нижн. обвязка 1945; 4044 1x 621/Нижн. обвязка 8520; 4054 1x 621/Нижн. обвязка 1945; 4059 1x 622/Верхн. обвязка 9480; 4061 1x 622/Верхн. обвязка 8120; 4066 1x 611/Столб 3252; 4076 1x 611/Столб 2200; 4077 1x 611/Столб 1499; 4080 1x 611/Столб 5840; 4088 1x 611/Столб 2200; 4089 1x 611/Столб 1499; 4092 1x 611/Столб 3252

Инв. № подл. Подп. и дата Взам. инв. №

# Раз

# вертка по

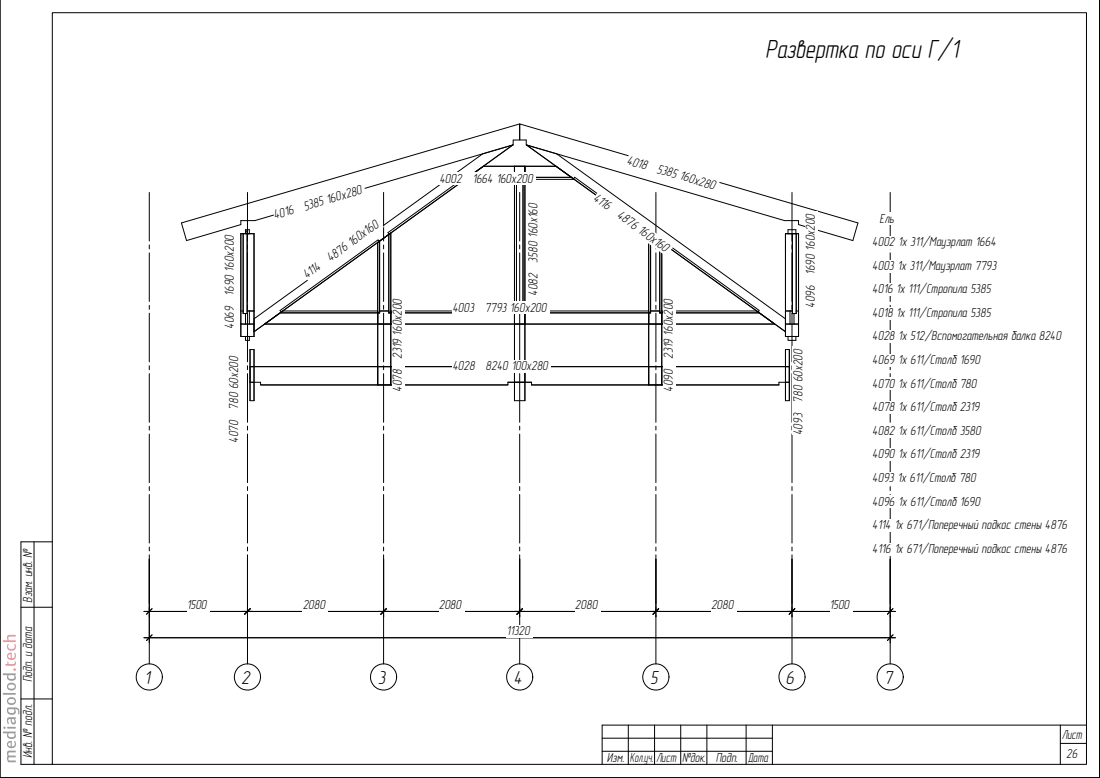
[picture p25: page 12]
оси; Ель 4002; 1x 311/Мауэрлат; 4003 1x 311/Мау; эрлат 7793; 4016 1x 111/Стро; пила 5385; 4018 1x 111/Стро; 1x 512/Вспо; огатель; ная; балка; 611/Столб 1690; 611/Столб; 611/Столб 3580; олб 780; пере; чный по; дкос; тены; 100x280 ⁴⁰⁸² ³⁵⁸⁰ ¹⁶⁰x¹60; №док.; Подп.; Дата

Инв. № подл. Подп. и дата Взам. инв. №

Изм. Кол.уч. Лист

# Развертка по оси Д

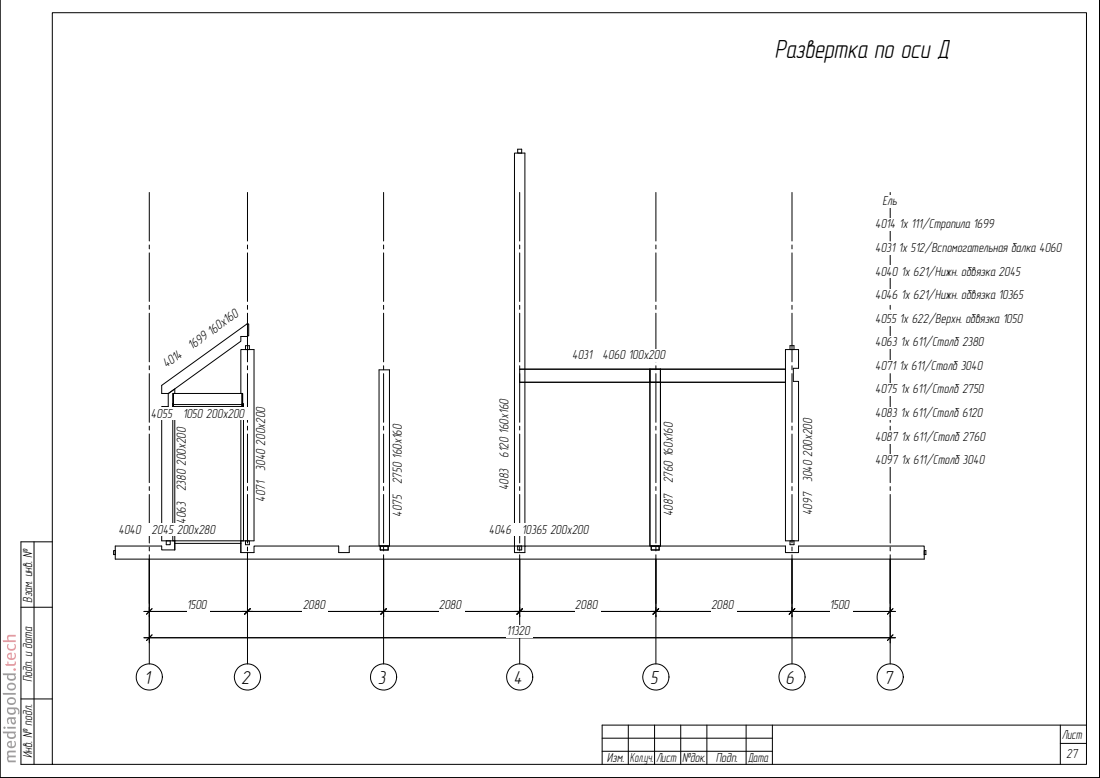
[picture p26: page 13]
Ель; 4014 1x 111/Стропила 1699; 4031 1x 512/Вспомогательная балка 4060; 4040 1x 621/Нижн. обвязка 2045; 4046 1x 621/Нижн. обвязка 10365; 4055 1x 622/Верхн. обвязка 1050; 4063 1x 611/Столб 2380; 4071 1x 611/Столб 3040; 4075 1x 611/Столб 2750; 4083 1x 611/Столб 6120; 4087 1x 611/Столб 2760; 4097 1x 611/Столб 3040

Инв. № подл. Подп. и дата Взам. инв. №

# Развертка по оси Ж

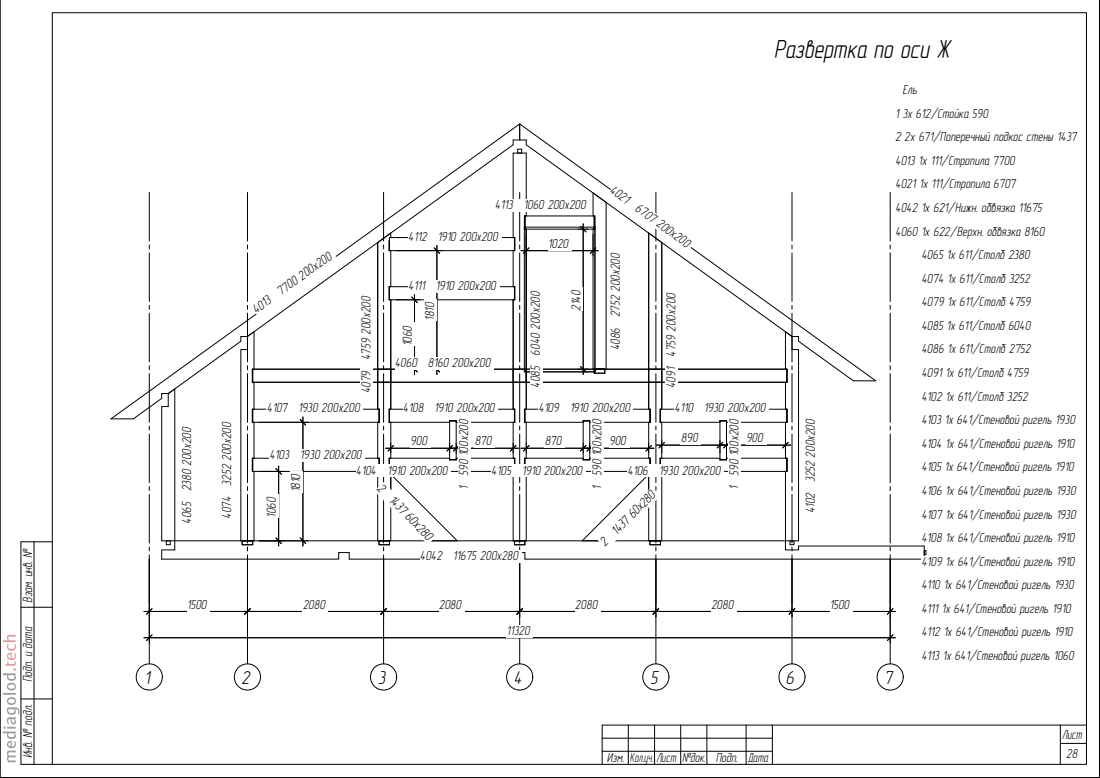
[picture p27: page 14]
Ель; 1 3x 612/Стойка 590; 2 2x 671/Поперечный подкос стены 1437; 4013 1x 111/Стропила 7700; 4021 1x 111/Стропила 6707; 4042 1x 621/Нижн. обвязка 11675; 4060 1x 622/Верхн. обвязка 8160; 4065 1x 611/Столб 2380; 4074 1x 611/Столб 3252; 4079 1x 611/Столб 4759; 4085 1x 611/Столб 6040; 4086 1x 611/Столб 2752; 4091 1x 611/Столб 4759; 4102 1x 611/Столб 3252; 4103 1x 641/Стеновой ригель 1930; 4104 1x 641/Стеновой ригель 1910; 4105 1x 641/Стеновой ригель 1910; 4106 1x 641/Стеновой ригель 1930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

Инв. № подл. Подп. и дата Взам. инв. №

# Развертка по

# оси 6

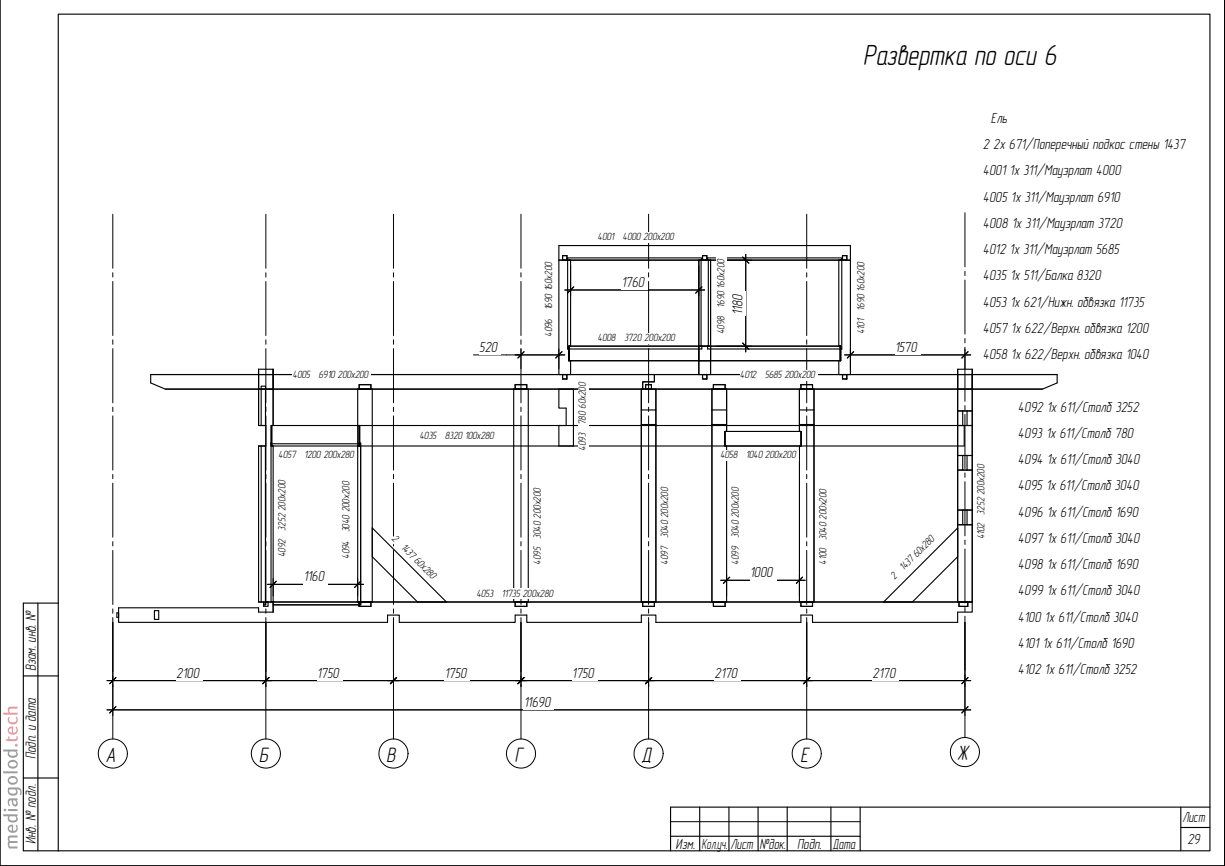
[picture p28: page 15]
Ель 2 2x 671/По; пере; чный; одкос; тены 1437; лат; 311/Мауэр; эрлат; лат 5685; 621/Нижн. обвязка 11735; №док.; Подп.; Дата

4001 1x 311/Мауэр
4008 1x 311/Мау
4012 1x 311/Мауэр
4035 1x 511/Балка
4057 1x 622/Верхн. обвязка 1200
4058 1x 622/Верхн. обвязка 1040 4092 1x 611/Столб 3252 4093 1x 611/Столб 780 4094 1x 611/Столб 3040 4095 1x 611/Столб 3040 4096 1x 611/Столб 1690 4097 1x 611/Столб 3040 4098 1x 611/Столб 1690 4099 1x 611/Столб 3040 4100 1x 611/Столб 3040 4101 1x 611/Столб 1690 4102 1x 611/Столб 3252

Инв. № подл. Подп. и дата Взам. инв. №

Изм. Кол.уч. Лист

# Развертка по оси 4

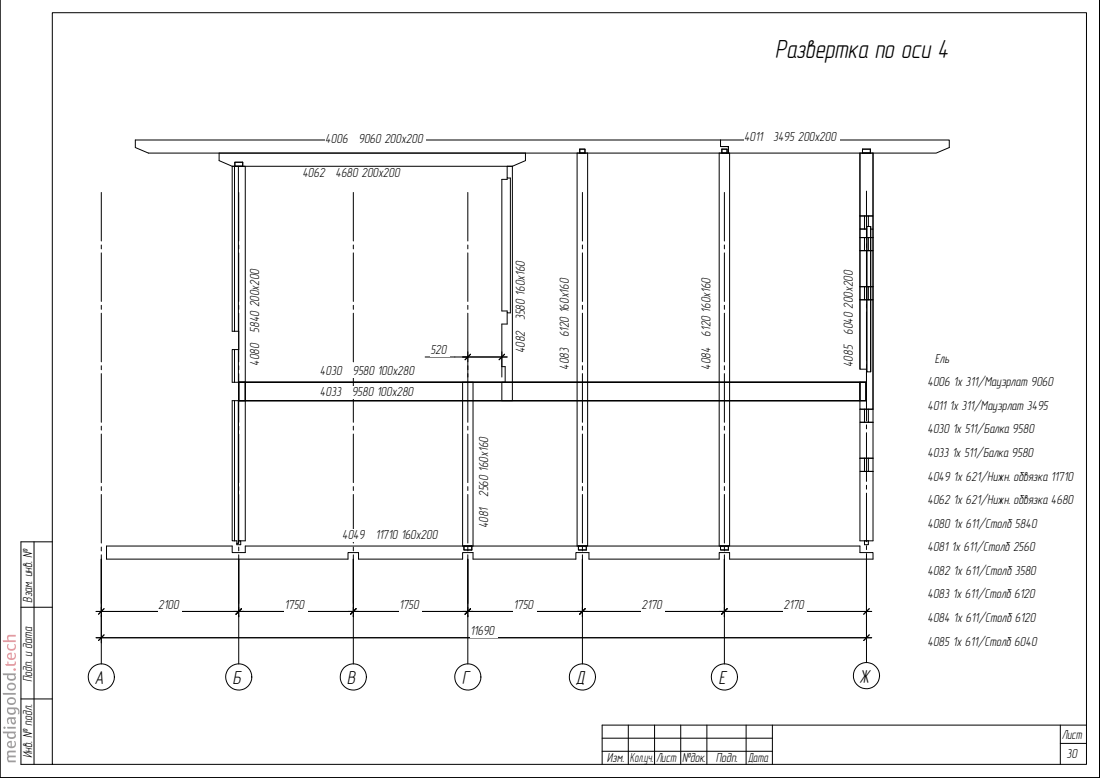
[picture p29: page 16]
Ель; 4006 1x 311/Мауэрлат 9060; 4011 1x 311/Мауэрлат 3495; 4030 1x 511/Балка 9580; 4033 1x 511/Балка 9580; 4049 1x 621/Нижн. обвязка 11710; 4062 1x 621/Нижн. обвязка 4680; 4080 1x 611/Столб 5840; 4081 1x 611/Столб 2560; 4082 1x 611/Столб 3580; 4083 1x 611/Столб 6120; 4084 1x 611/Столб 6120; 4085 1x 611/Столб 6040

Инв. № подл. Подп. и дата Взам. инв. №

# Развертка по оси 2

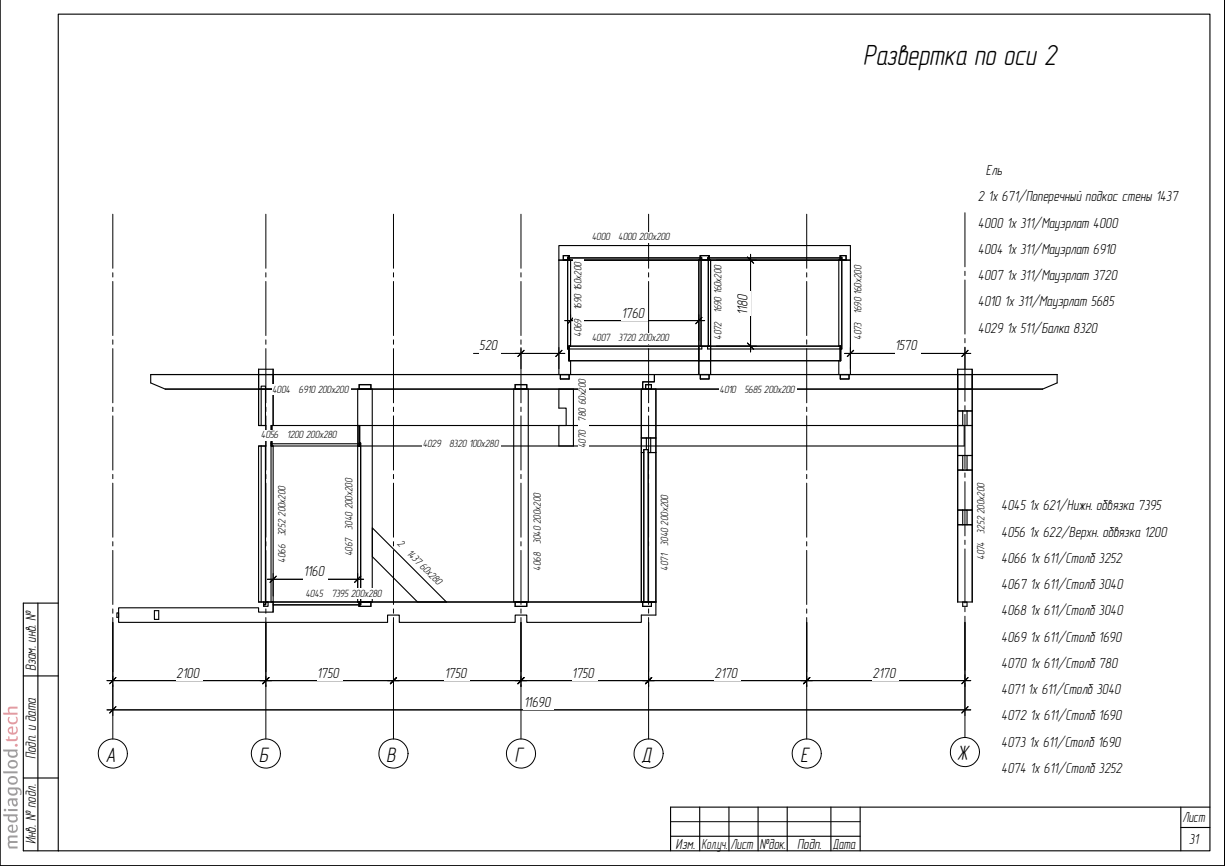
[picture p30: page 17]
Ель; 2 1x 671/Поперечный подкос стены 1437; 4000 1x 311/Мауэрлат 4000; 4004 1x 311/Мауэрлат 6910; 4007 1x 311/Мауэрлат 3720; 4010 1x 311/Мауэрлат 5685; 4029 1x 511/Балка 8320; 4045 1x 621/Нижн. обвязка 7395; 4056 1x 622/Верхн. обвязка 1200; 4066 1x 611/Столб 3252; 4067 1x 611/Столб 3040; 4068 1x 611/Столб 3040; 4069 1x 611/Столб 1690; 4070 1x 611/Столб 780; 4071 1x 611/Столб 3040; 4072 1x 611/Столб 1690; 4073 1x 611/Столб 1690; 4074 1x 611/Столб 3252

Инв. № подл. Подп. и дата Взам. инв. №

# Развертка по оси 1

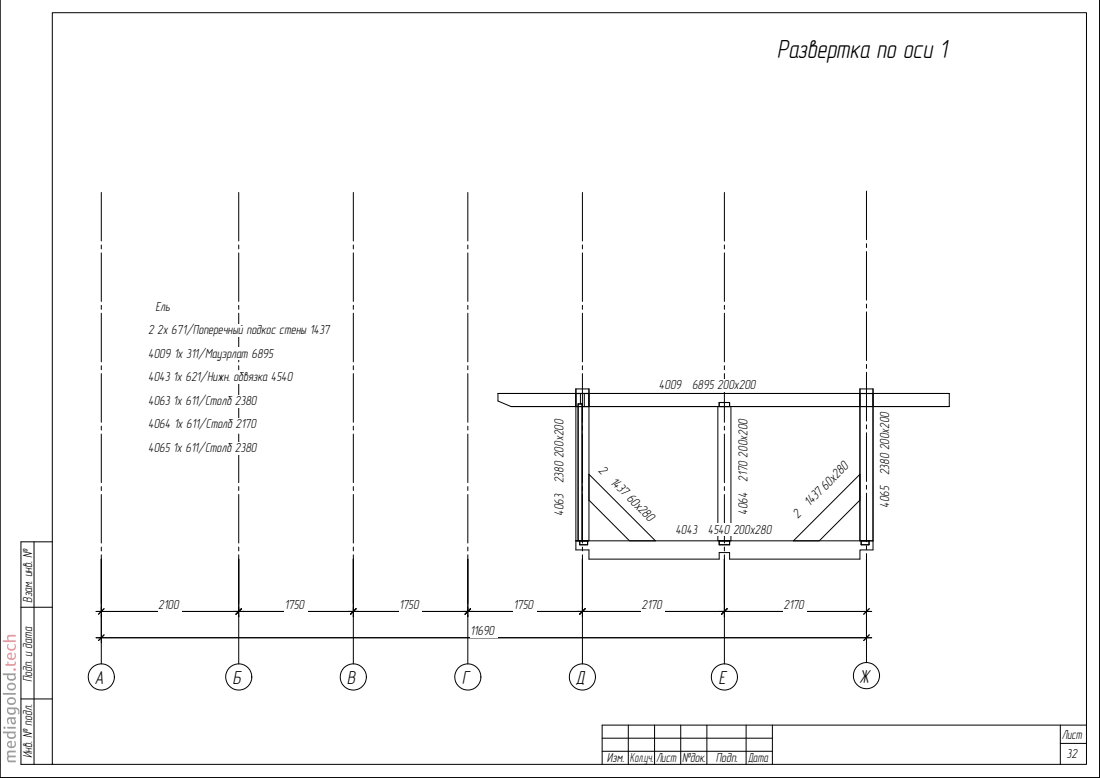
[picture p31: page 18]
Ель; 4064 1x 611/Столб 2170

Ель
2 2x 671/Поперечный подкос стены 1437
4009 1x 311/Мауэрлат 6895
4043 1x 621/Нижн. обвязка 4540
4063 1x 611/Столб 2380
4064 1x 611/Столб 2170
4065 1x 611/Столб 2380

Инв. № подл. Подп. и дата Взам. инв. №
