ogoldeliy/fachwerk-project-173/03 ижд Лестница.pdf

# Схема установки тетив лестницы Ель

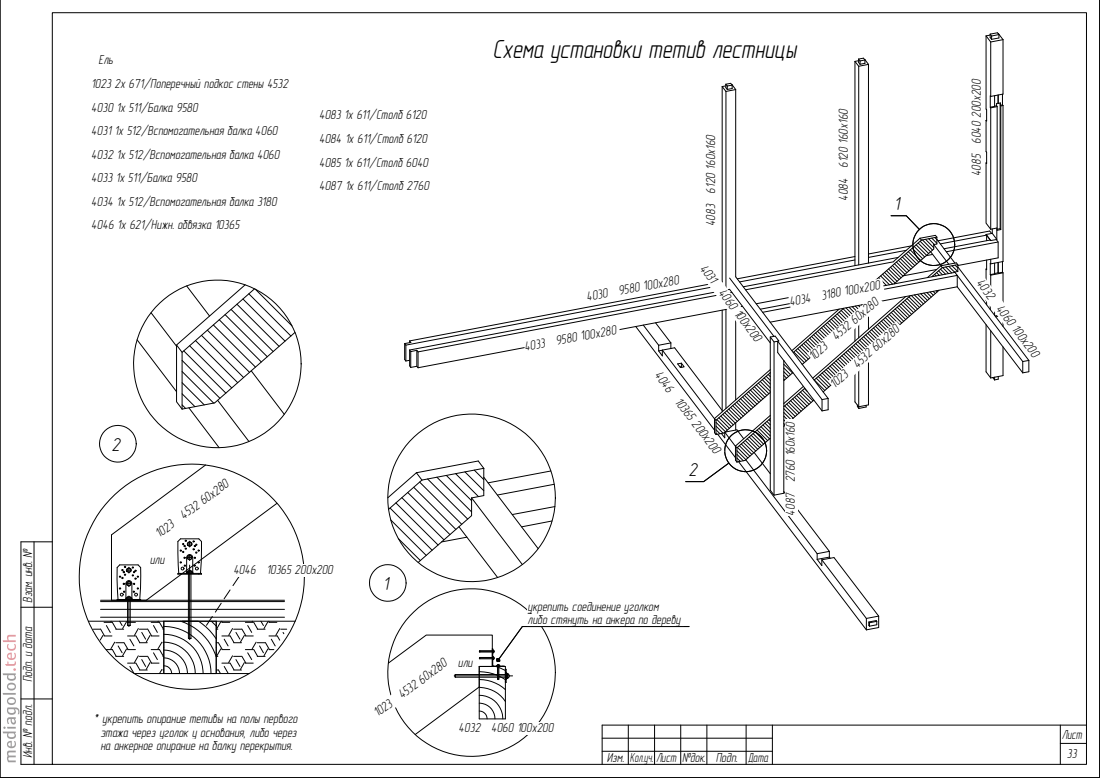
[picture p32: page 1]
4083 1x 611/Столб 6120; 4084 1x 611/Столб 6120; 4085 1x 611/Столб 6040; 4087 1x 611/Столб 2760; или; Изм. Кол.уч. Лист №док.; Подп.; Дата; Лист 33

Ель
1023 2x 671/Поперечный подкос стены 4532
4030 1x 511/Балка 9580
4031 1x 512/Вспомогательная балка 4060
4032 1x 512/Вспомогательная балка 4060
4033 1x 511/Балка 9580
4034 1x 512/Вспомогательная балка 3180
4046 1x 621/Нижн. обвязка 10365

Инв. № подл. Подп. и дата Взам. инв. №

укрепить соединение уголком
либо стянуть на анкера по дереву

* укрепить опирание тетивы на полы первого
этажа через уголок у основания, либо через
на анкерное опирание на балку перекрытия.
