ogoldeliy/fachwerk-project-173/План свайного поля.pdf

# План

# свайного

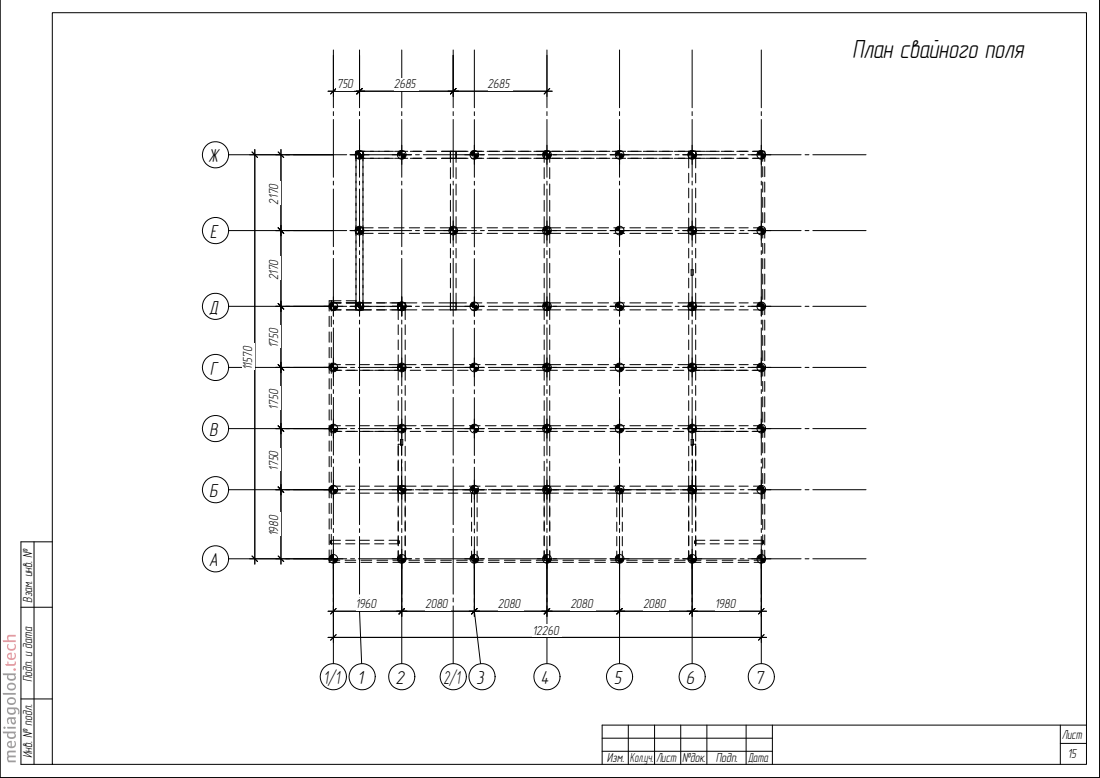
[picture p33: page 1]
поля; №док.; Подп.; Дата; Лист 15

Инв. № подл. Подп. и дата Взам. инв. №

Изм. Кол.уч. Лист
