ogoldeliy/fachwerk-project-173/Остекление/05 ижд БЕЗРАМНОЕ.pdf

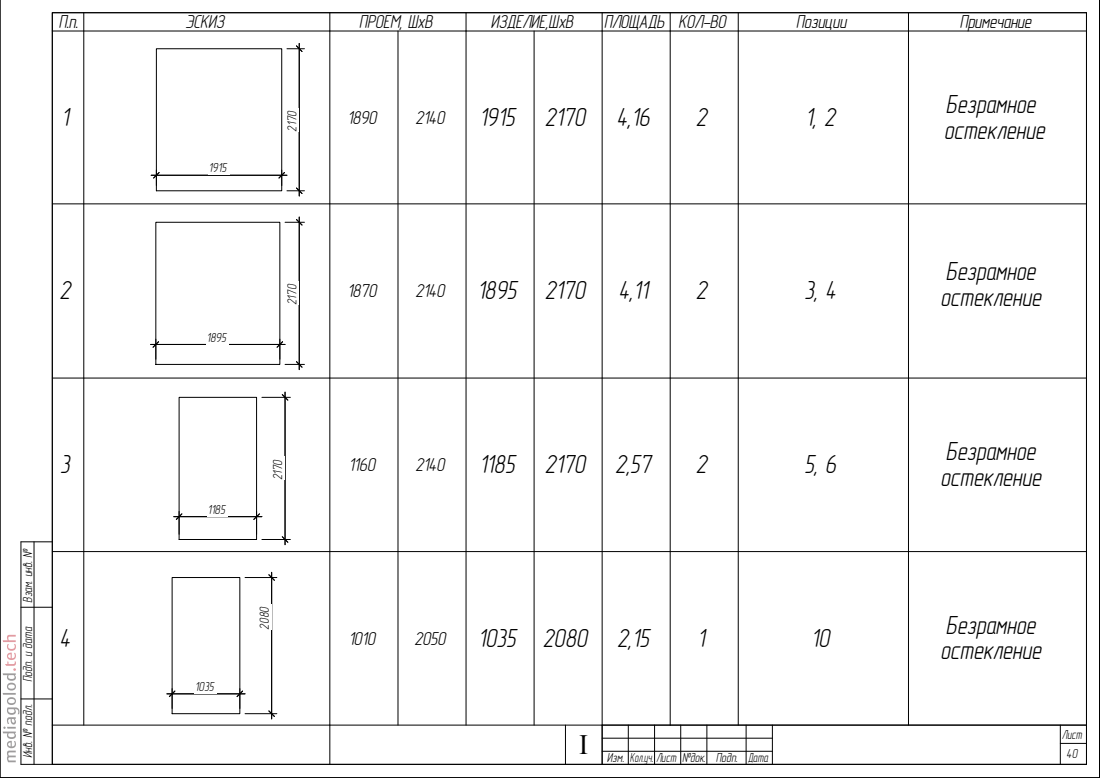
[picture p34: page 1]
Изм. Кол.уч. Лист №док.; Подп.; Дата

П.п. | ЭСКИЗ | ПРОЁМ, ШхВ | ИЗДЕЛИЕ,ШхВ | ПЛОЩАДЬ | КОЛ-ВО | Позиции | Примечание

1 | | | 1890 | 2140 | 1915 | 2170 | 4,16 | 2 | 1, 2 | Безрамное остекление

2 | | | 1870 | 2140 | 1895 | 2170 | 4,11 | 2 | 3, 4 | Безрамное остекление

3 | | | 1160 | 2140 | 1185 | 2170 | 2,57 | 2 | 5, 6 | Безрамное остекление

Инв. № подл. Подп. и дата Взам. инв. №

4 | | | 1010 | 2050 | 1035 | 2080 | 2,15 | 1 | 10 | Безрамное остекление

I | | | | | | | | Лист

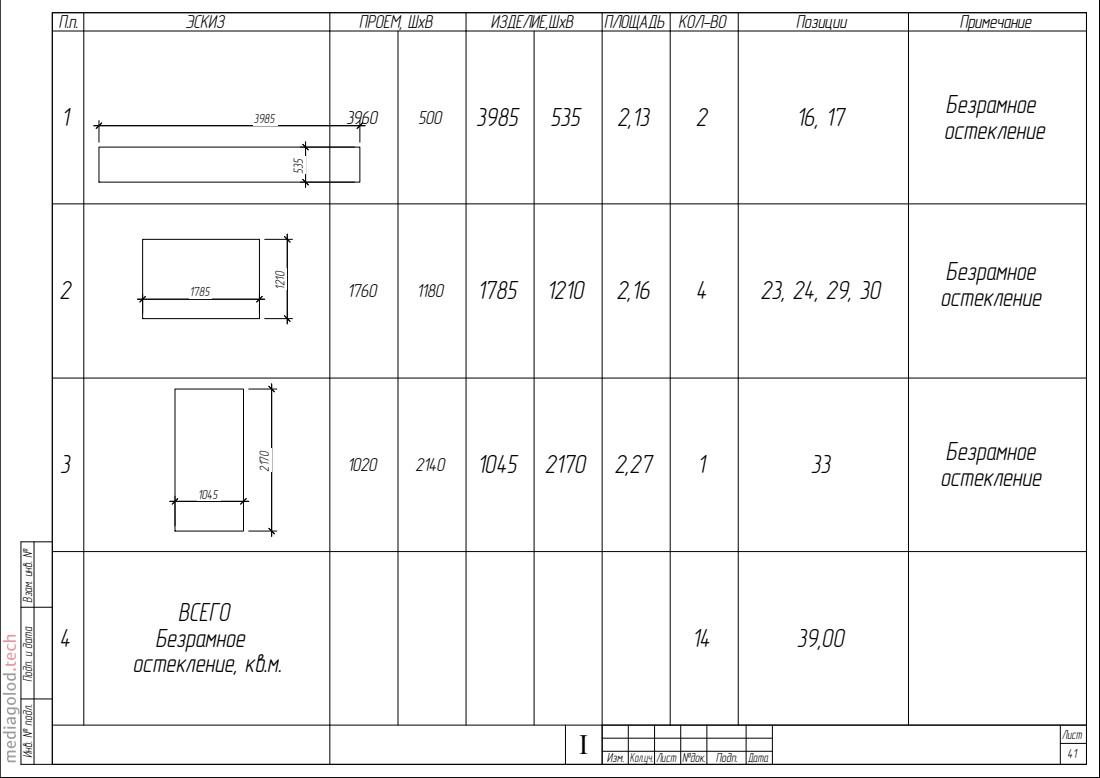
[picture p35: page 2]

1 | 3985 | 3960 | 500 | 3985 | 535 | 2,13 | 2 | 16, 17 | Безрамное остекление

2 | | | 1760 | 1180 | 1785 | 1210 | 2,16 | 4 | 23, 24, 29, 30 | Безрамное остекление

3 | | | 1020 | 2140 | 1045 | 2170 | 2,27 | 1 | 33 | Безрамное остекление

Инв. № подл. Подп. и дата Взам. инв. №

4 | ВСЕГО Безрамное остекление, кв.м. | | | | | | | 14 | 39,00

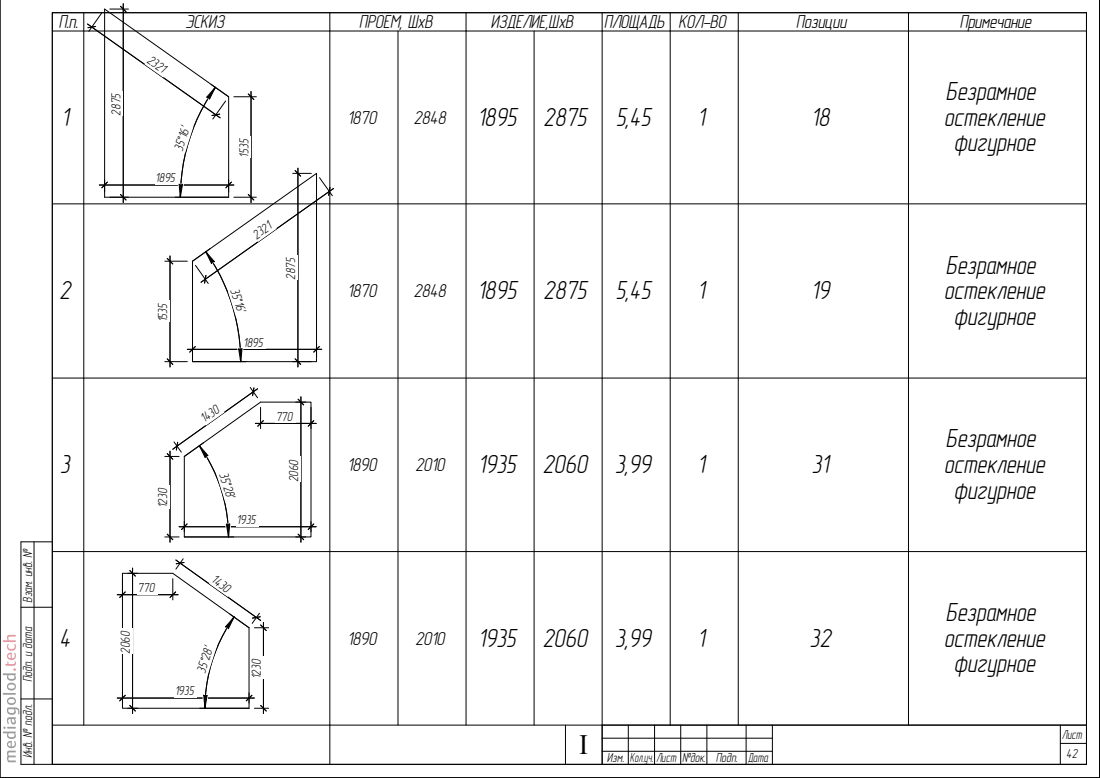
[picture p36: page 3]

1 | | 1870 | 2848 | 1895 | 2875 | 5,45 | 1 | 18 | Безрамное остекление фигурное

2 | | 1870 | 2848 | 1895 | 2875 | 5,45 | 1 | 19 | Безрамное остекление фигурное

3 | 1890 | 2010 | 1935 | 2060 | 3,99 | 1 | 31 | Безрамное остекление фигурное

Инв. № подл. Подп. и дата Взам. инв. №

4 | 1890 | 2010 | 1935 | 2060 | 3,99 | 1 | 32 | Безрамное остекление фигурное

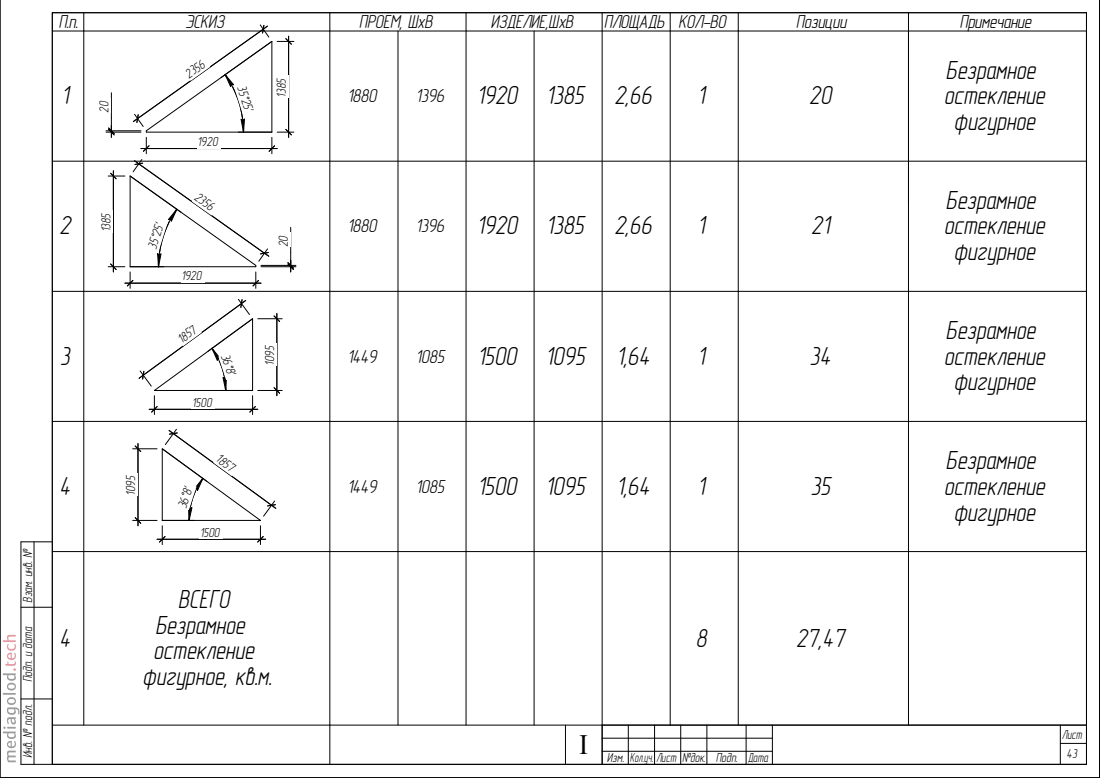
[picture p37: page 4]
фигурное, кв.м.; Позиции; №док.; Подп.; Дата

П.п. | ЭСКИЗ | ПРОЁМ, ШхВ | ИЗДЕЛИЕ, ШхВ | ПЛОЩАДЬ | КОЛ-ВО | | Примечание
1 | | | | | 1880 | 1396 | 1920 | 1385 | 2,66 | 1 | 20 | Безрам ное ост екление фигурное

1880 | 1396 | 1920 | 1385 | 2,66 | 1 | 21 | Безрам ное ост екление фигурное

фигурное Безрамное остекление фигурное

1449 | 1085 | 1500 | 1095 | 1,64 | 1 | 35 | Безрам ное ост екление

Инв. № подл. Подп. и дата Взам. инв. №

4 | ВСЕГО Безрам ное ост екление | | | | | | | 8 | 27,47

Изм. Кол.уч. Лист
