ogoldeliy/fachwerk-project-173/Остекление/05 ижд РАЗВЕРТКИ.pdf

# План

# первого

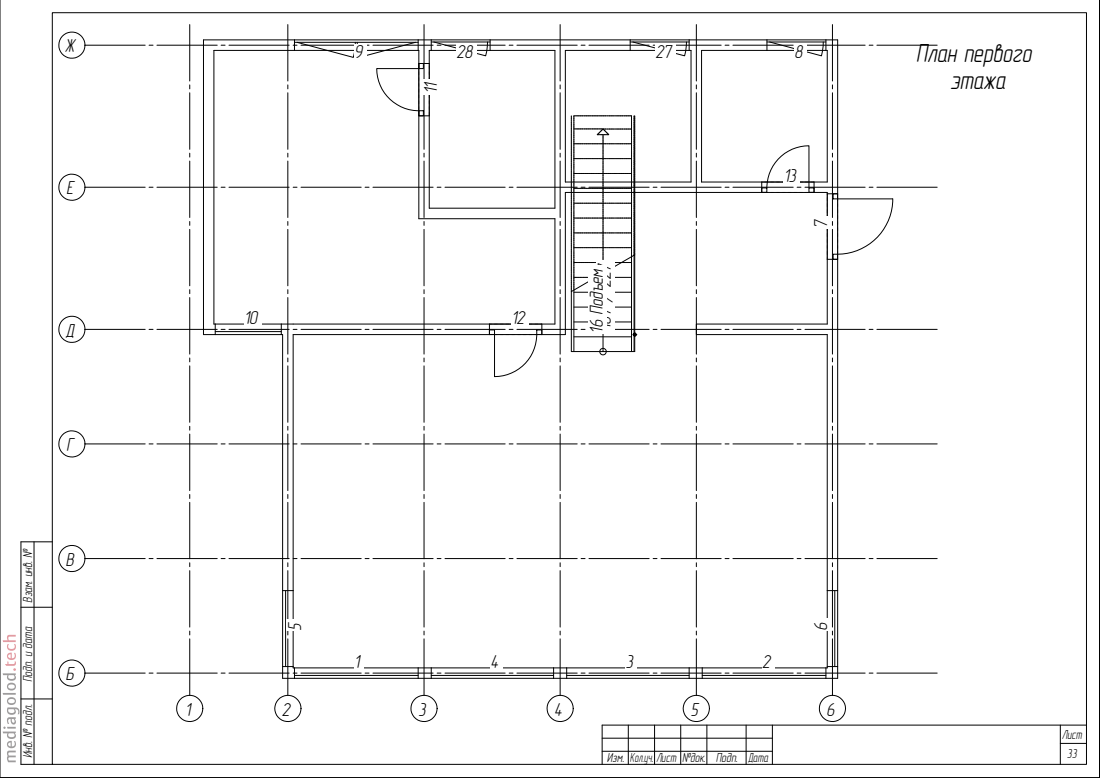
[picture p38: page 1]
ажа; План; первого эт; 16 167 / 227 Подъем; №док.; Подп.; Дата; Лист

Инв. № подл. Подп. и дата Взам. инв. №

Изм. Кол.уч. Лист

# План

вт

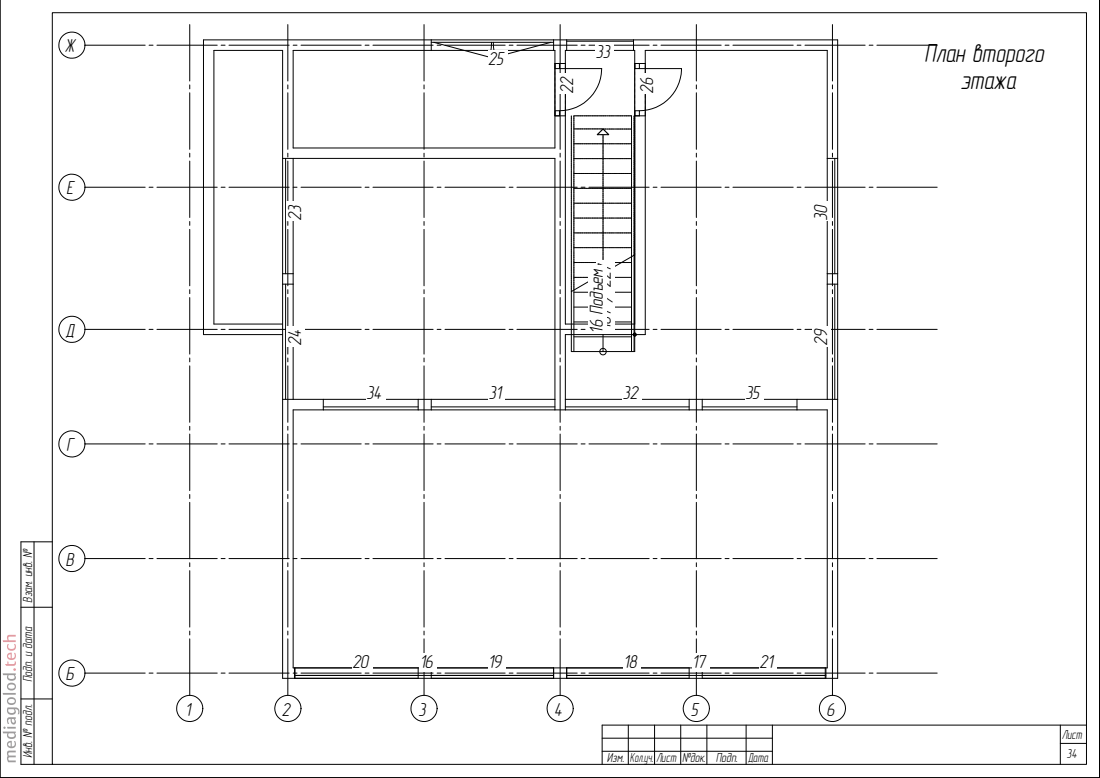
[picture p39: page 2]
орого; ажа; План; 26 16 167 / ²²⁷ Подъем

Инв. № подл. Подп. и дата Взам. инв. №

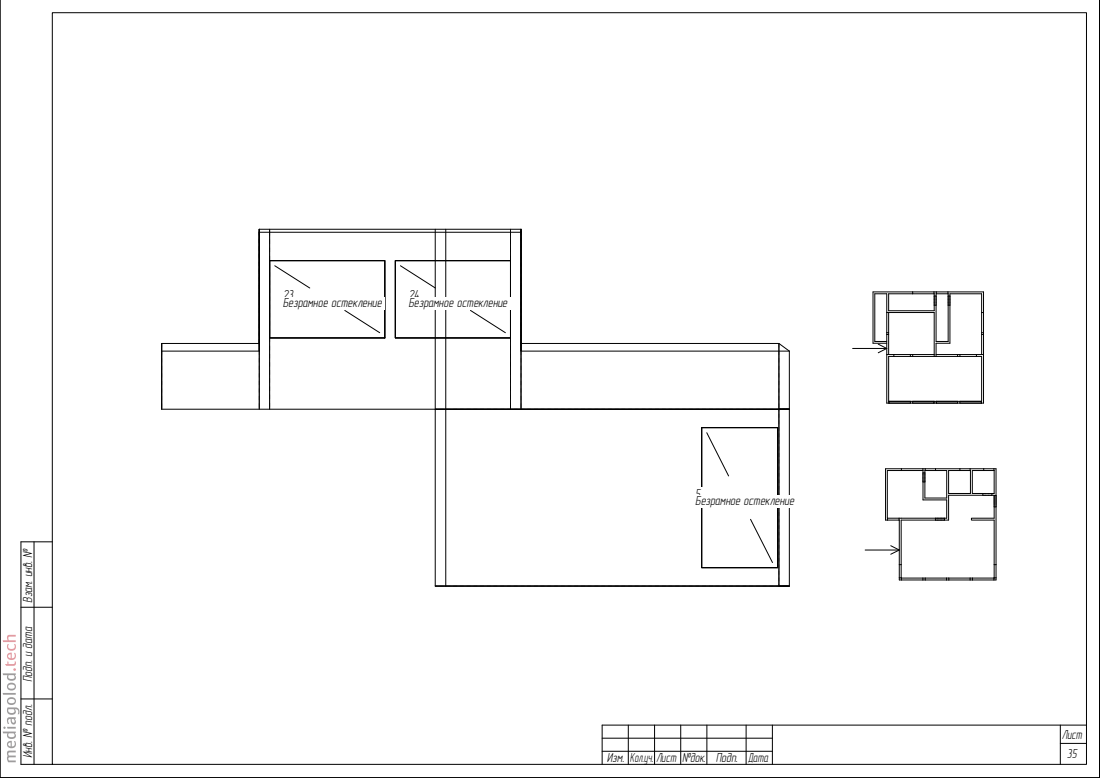
[picture p40: page 3]
5Безр ам; ное; екле; ние; 23Безрамное ос текление; 24Безрамное ос т; кление

Инв. № подл. Подп. и дата Взам. инв. №

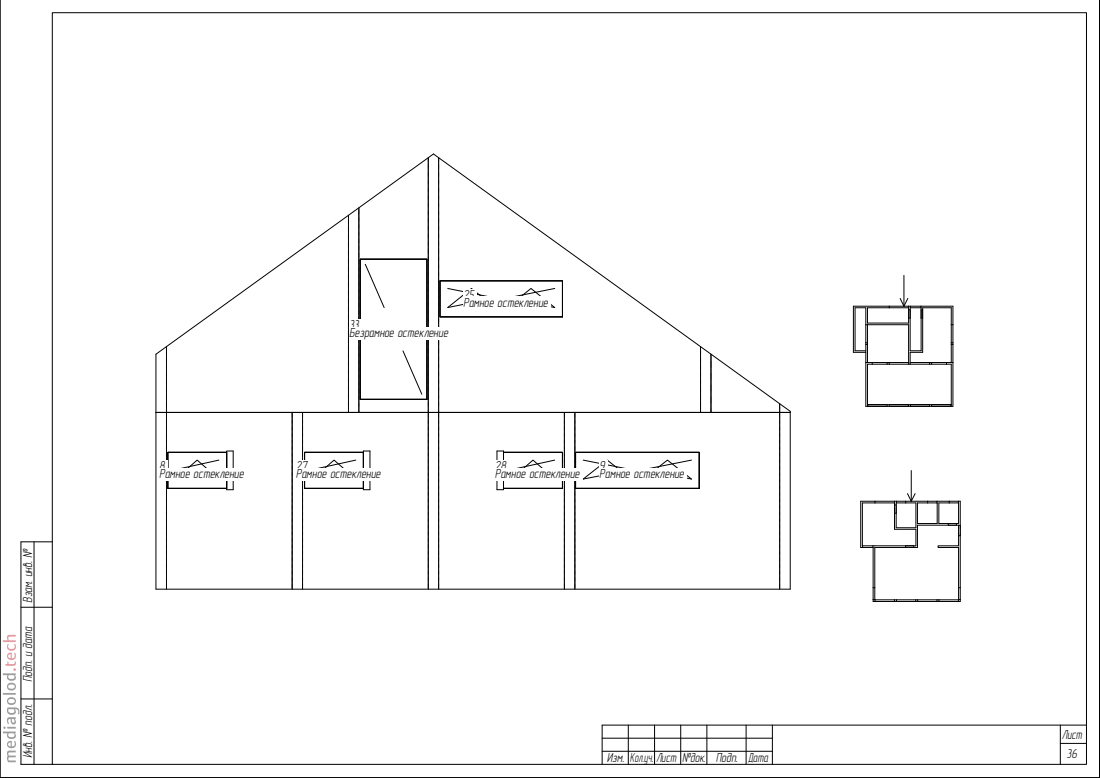
[picture p41: page 4]
9 Рамное остекление; 8 Рамное остекление; 27 Рамное остекление; 28 Рамное остекление; 25 Рамное остекление; 33 Безрамное остекление

Инв. № подл. Подп. и дата Взам. инв. №

Изм. Кол.уч. Лист №док. Подп. Дата

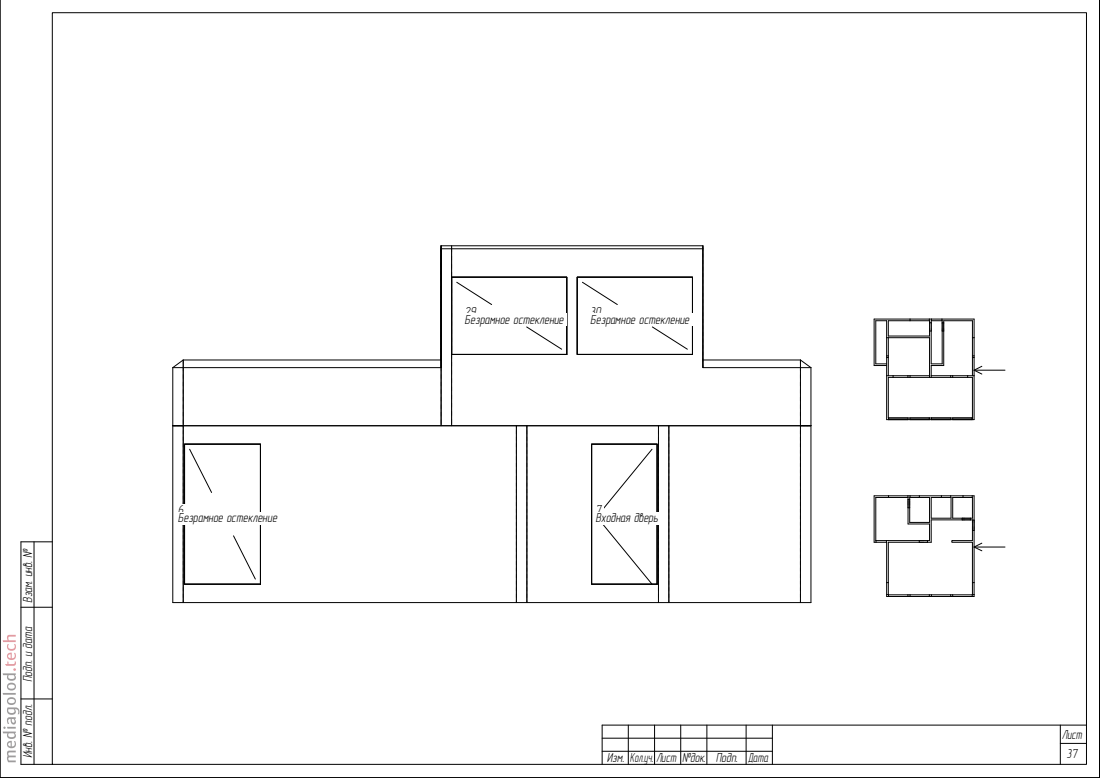
[picture p42: page 5]
30Безр ам; ное; екле; ние; 29Безрам ное; 7Входная; дверь; 6Безрамное ос текление

Инв. № подл. Подп. и дата Взам. инв. №

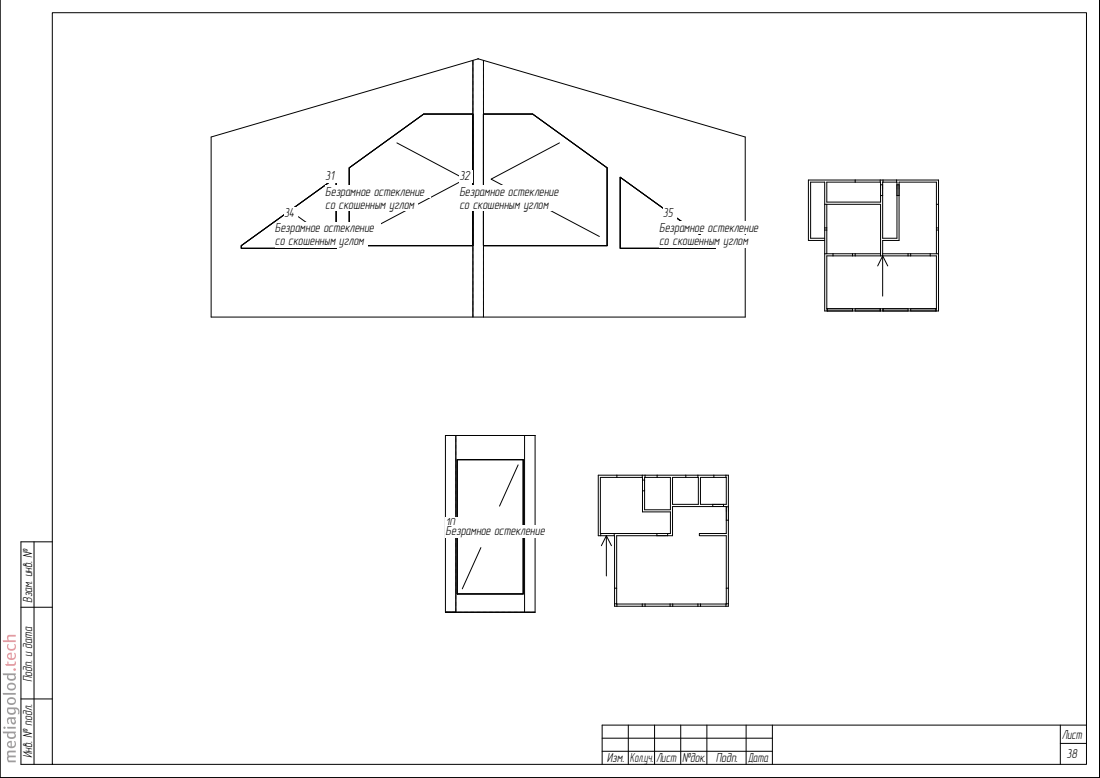
[picture p43: page 6]
10 Безрамное остекление; 31 Безрамное остекление; 32 Безрамное остекление; Безрамное остекление

Безрамное остекление
со скошенным углом

Инв. № подл. Подп. и дата Взам. инв. №

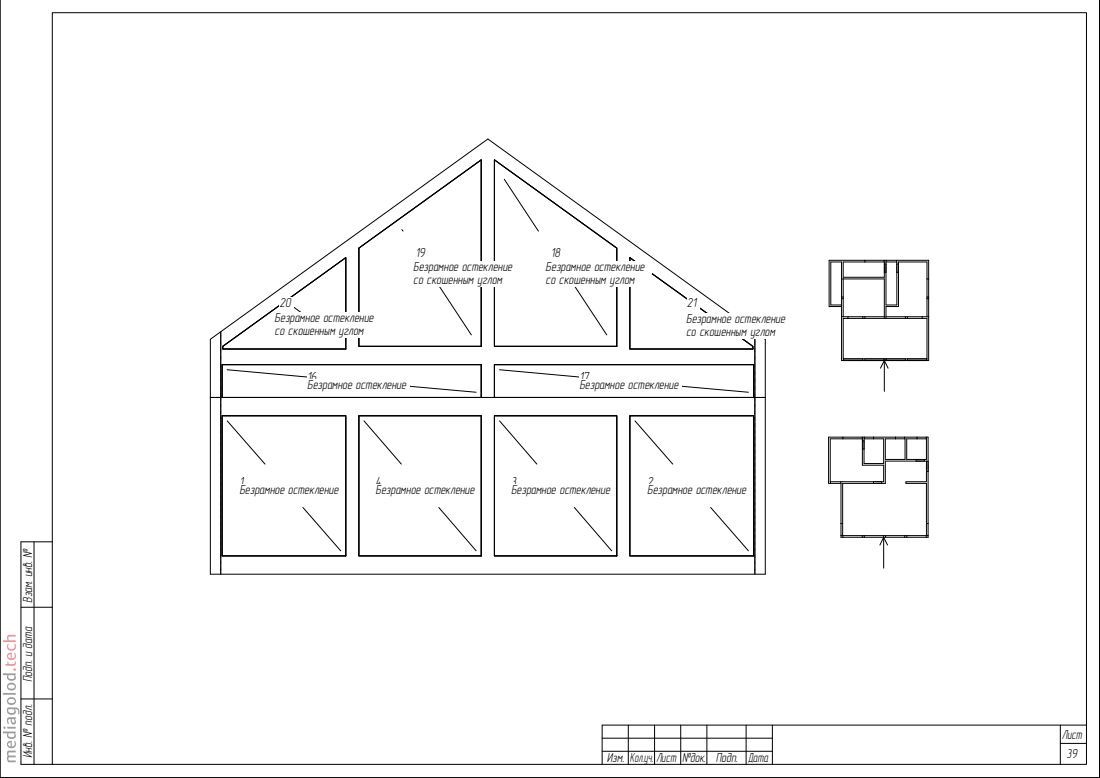
[picture p44: page 7]
3 Безрамное остекление; 4 Безрамное остекление; 1 Безрамное остекление; 2 Безрамное остекление; 16 Безрамное остекление; 17 Безрамное остекление; Безрамное остекление со скошенным углом

Безрамное остекление
со скошенным углом

Инв. № подл. Подп. и дата Взам. инв. №
